The-Jaaa/esp32-autonomous-chessboard/docs/final-presentation.pdf

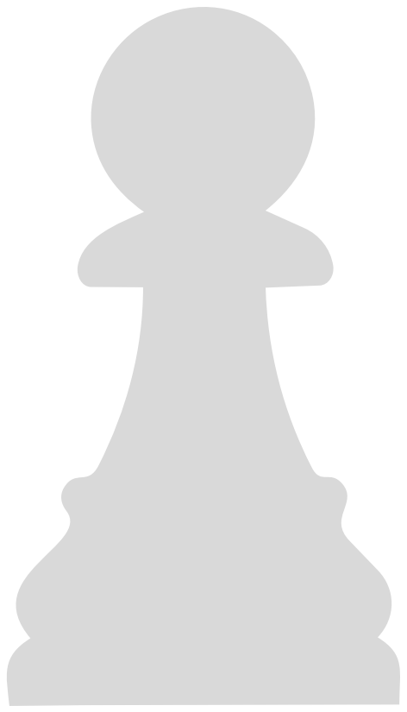
[picture p3: figure]

# CHESS COMPANION

IN 1901 - Microcontroller Based Application Development Project

IT Group 27 - Roasted Resistors

# TEAM MEMBERS

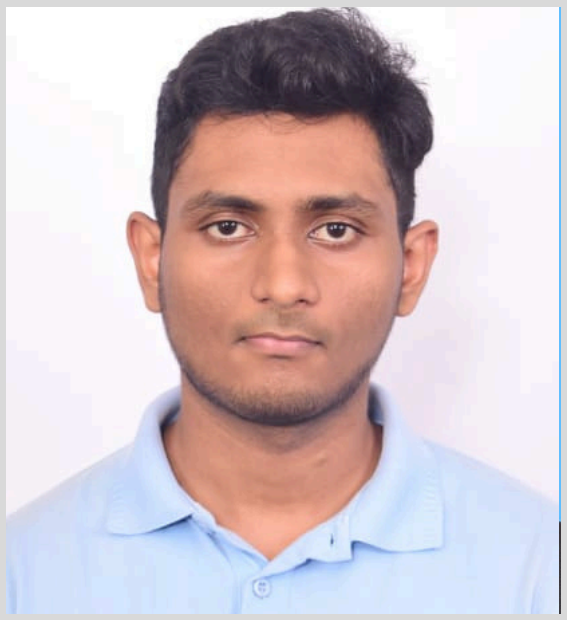
[picture p4: figure]

Thejaka Seneviratne
244195V

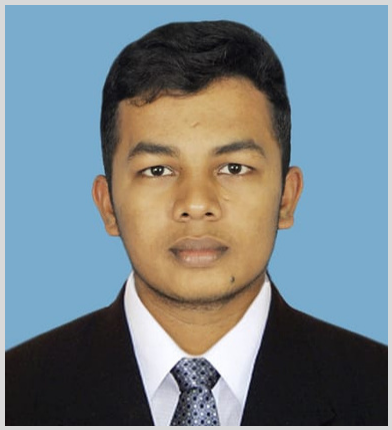
[picture p5: figure]

Sithum Sandaruwan
244189G

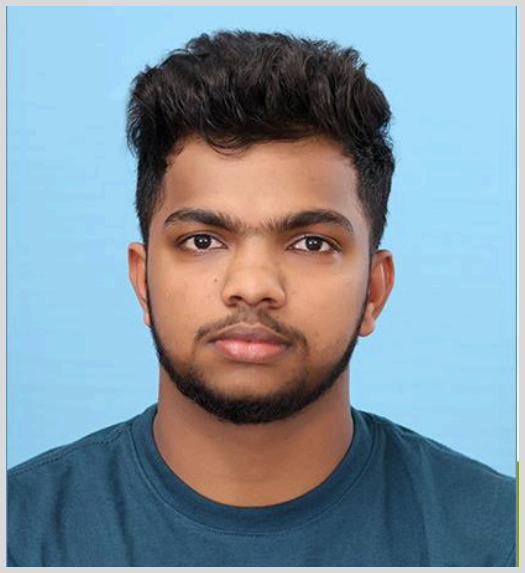
[picture p6: figure]

Avindu Thilakarathne
244206J

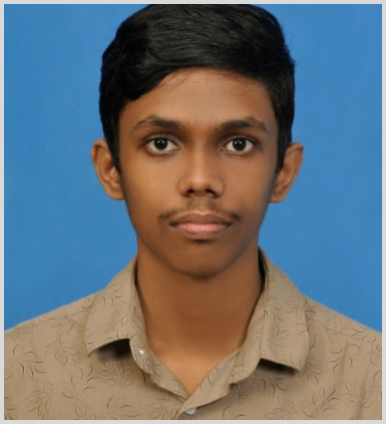
[picture p7: figure]

Sahan Wijerathne
244227A

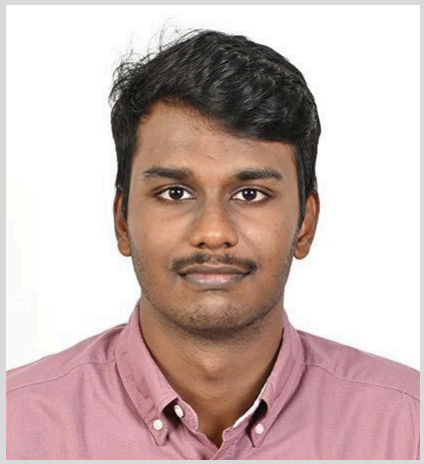
[picture p8: figure]

Harishan Nirmalan
244074B

# Table of Content

## Introduction Aim Objective Problem Solution Block Diagram

## Components

## Schematics

## Product View Work Distribution

# Introduction

Autonomous Chessboard is a smart physical chessboard that combines sensors, motors, electronics, and AI. In a game, a human plays one side while the Stockfish chess engine plays the other. Hall-effect sensors detect the positions of the pieces, while an ESP32-S3 controls a moving system and electromagnet to move the engine’s pieces automatically. The board has 256 LEDs that show legal moves, captures, special moves, warnings, and game results. Speakers provide voice feedback and coaching through a Gemini mentor, which can analyze positions, explain mistakes, change the difficulty level, and teach chess openings. A web application connects and controls all these features. Offline engine support and fully standalone play are also being

developed.

# AIM

The aim of this project is to develop an autonomous physical chessboard that allows a human player to play against an AI opponent in a realistic and interactive way. By combining a real chessboard with artificial intelligence, the project aims to make chess practice more engaging, reduce dependence on

screens, and help players improve their skills.

# OBJECTIVES

## To build a physical chessboard that can move pieces automatically using a

hidden gantry and electromagnet.
To use Hall-effect sensors to detect the position of every chess piece.

## To integrate Stockfish so the system can play against a human at different

difficulty levels.
To use LEDs to show legal moves, captures, warnings, and game results. To develop a web application for game settings and live game information.

## To add speakers and a Gemini voice mentor for chess explanations and

coaching.

## To combine all hardware and software components into one reliable chess-

playing system.

# PROBLEM

## Finding a human opponent is not always easy, making solo chess practice

difficult.

## Digital chess applications require long periods of screen use, which can cause

eye strain.

## Digital platforms do not provide the physical experience of moving real chess

pieces.

## Traditional chessboards usually do not provide an automatic opponent, move

guidance, or learning support.

## There is a need for a system that combines the physical experience of chess with

the benefits of AI.

# SOLUTION

## Provide an AI opponent using Stockfish so players can practise chess without

needing another person.

## Use a physical board with real chess pieces to create a more hands-on

experience.
Use sensors to detect player moves and automatically move the AI’s pieces. Use LEDs to show legal moves, captures, warnings, and other game information.

## Use speakers and a Gemini voice mentor to explain moves and help players

learn.

## Use a web application to manage the game, settings, difficulty level, and live

board state.

## Reduce the need for continuous screen use while keeping the benefits of a digital

chess system.

B

L

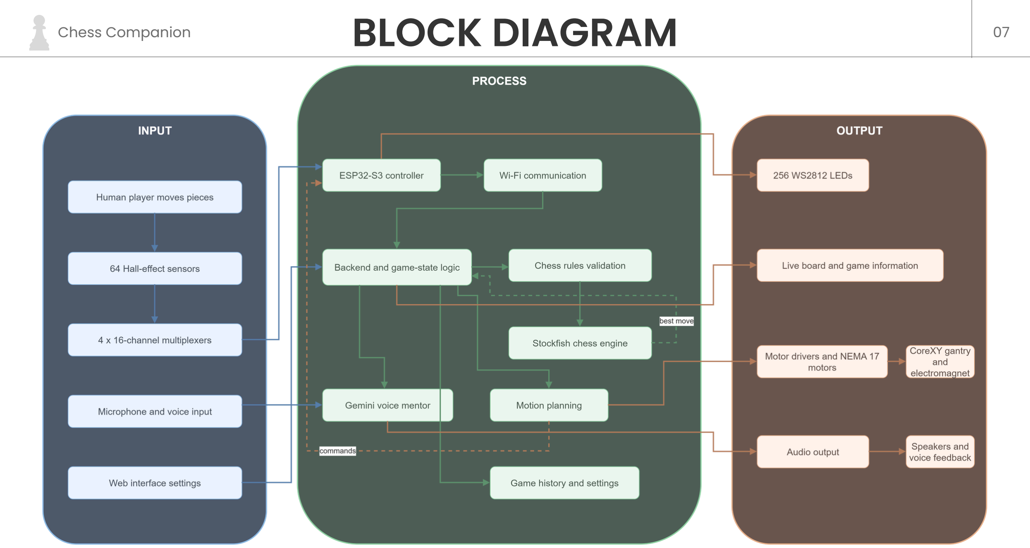
[picture p9: page 9]

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
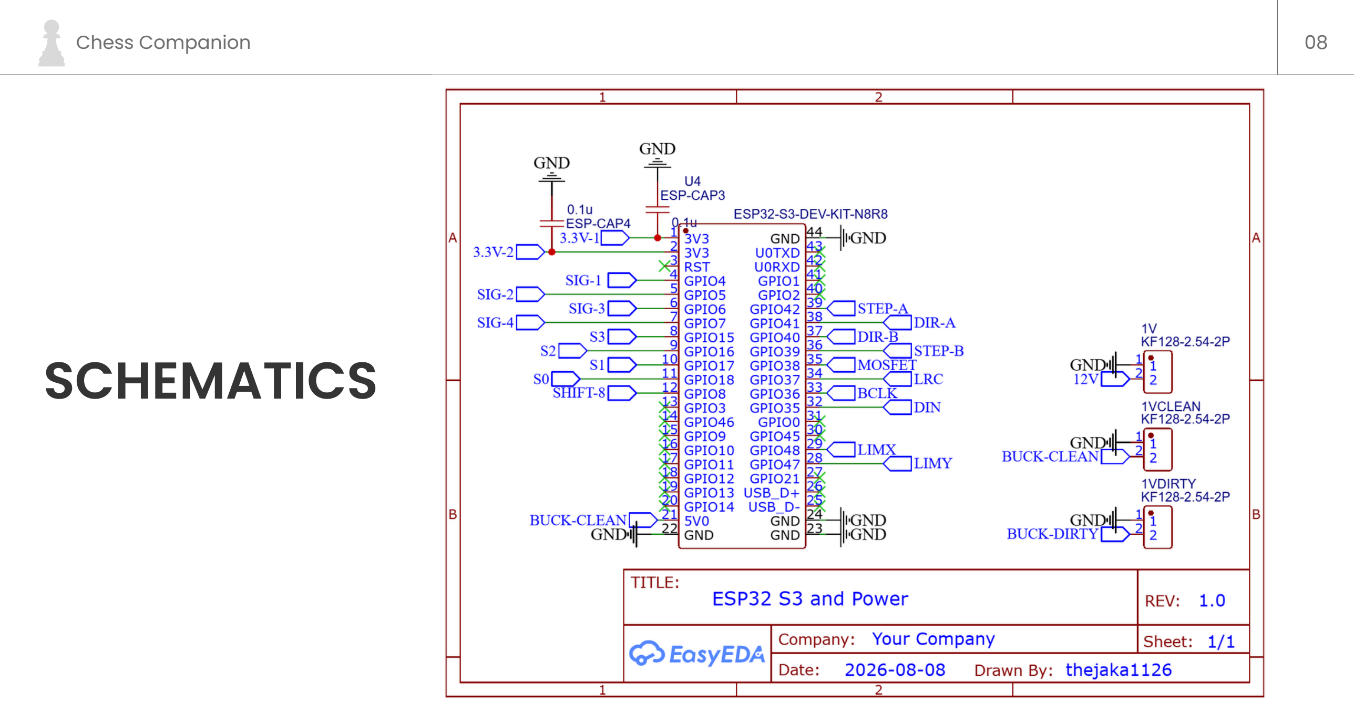
[picture p10: figure]
SCHEMATICS

S

C

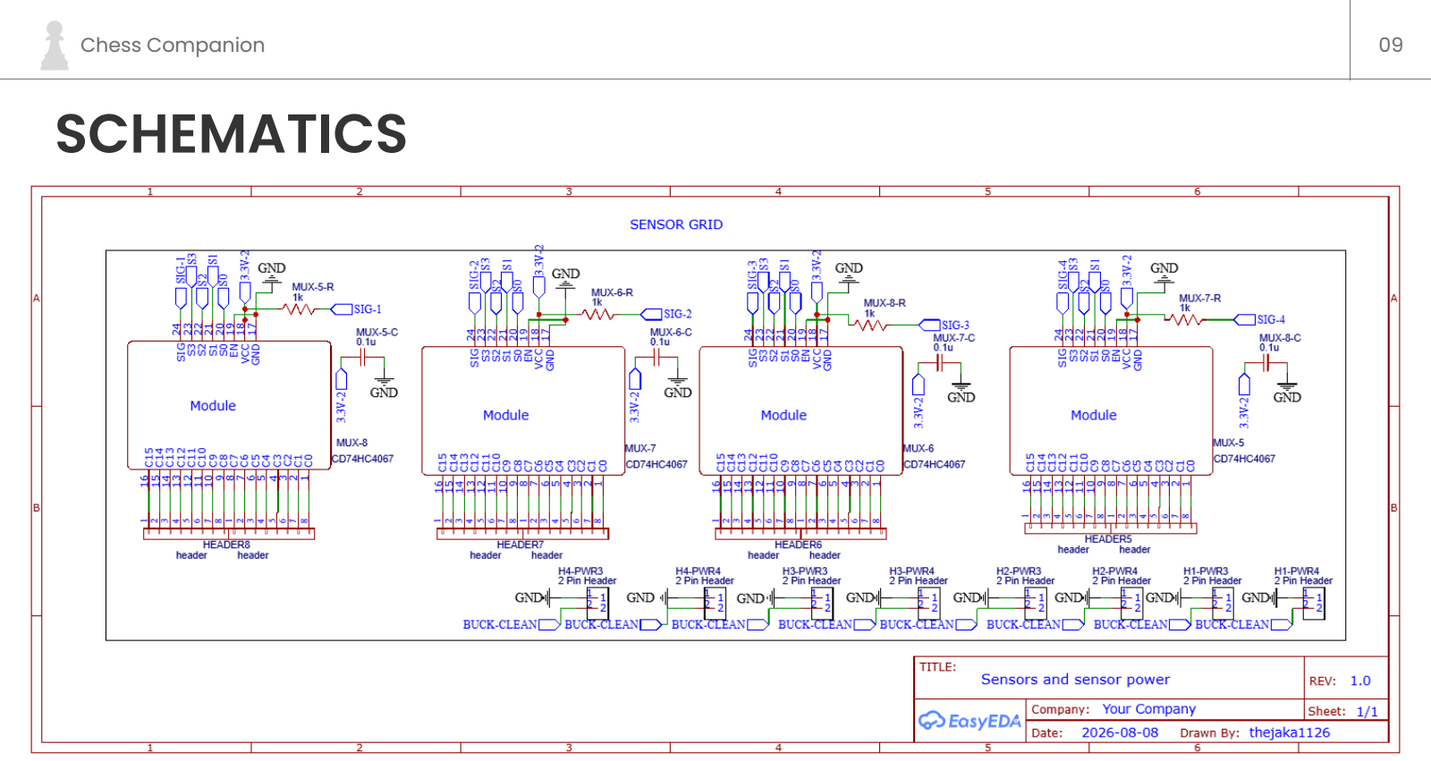
[picture p11: page 11]

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
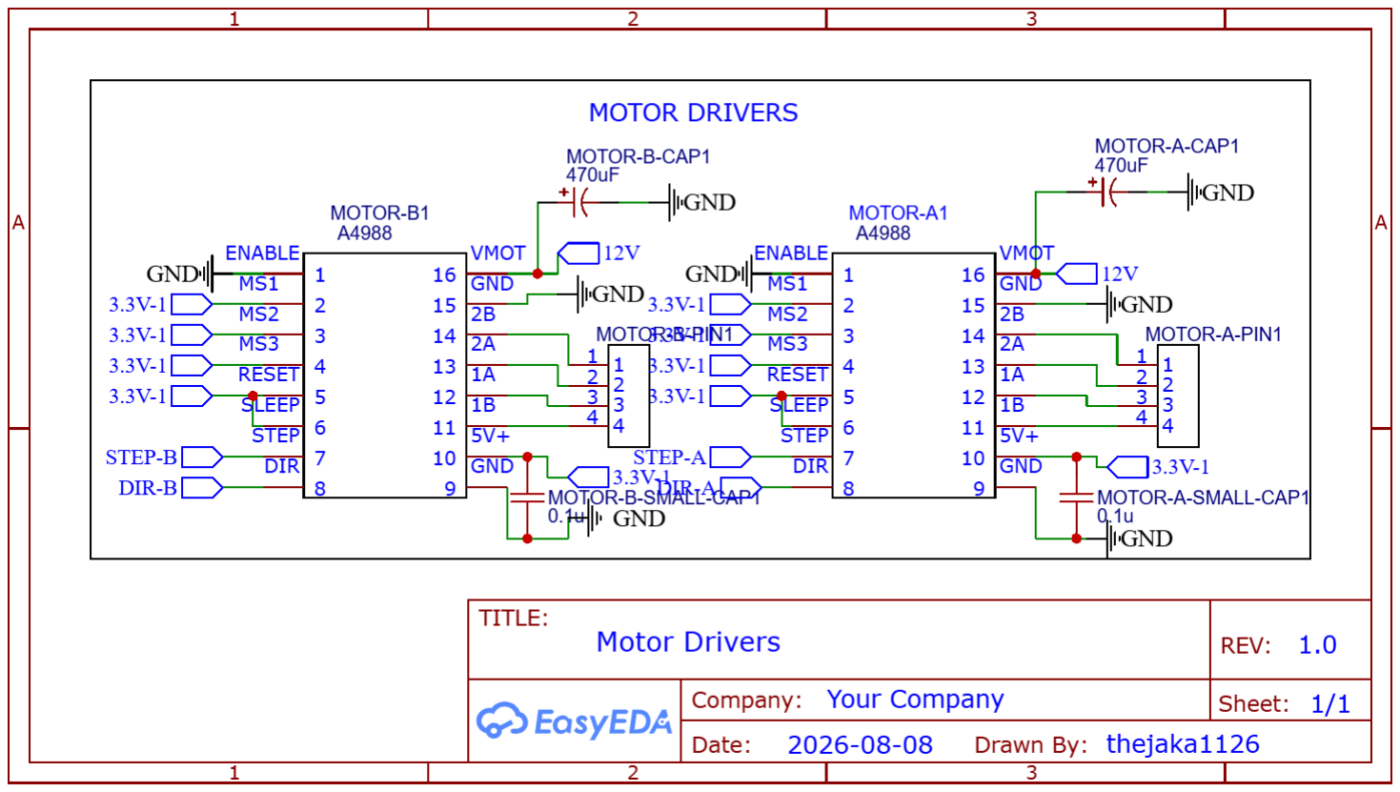
[picture p12: figure]

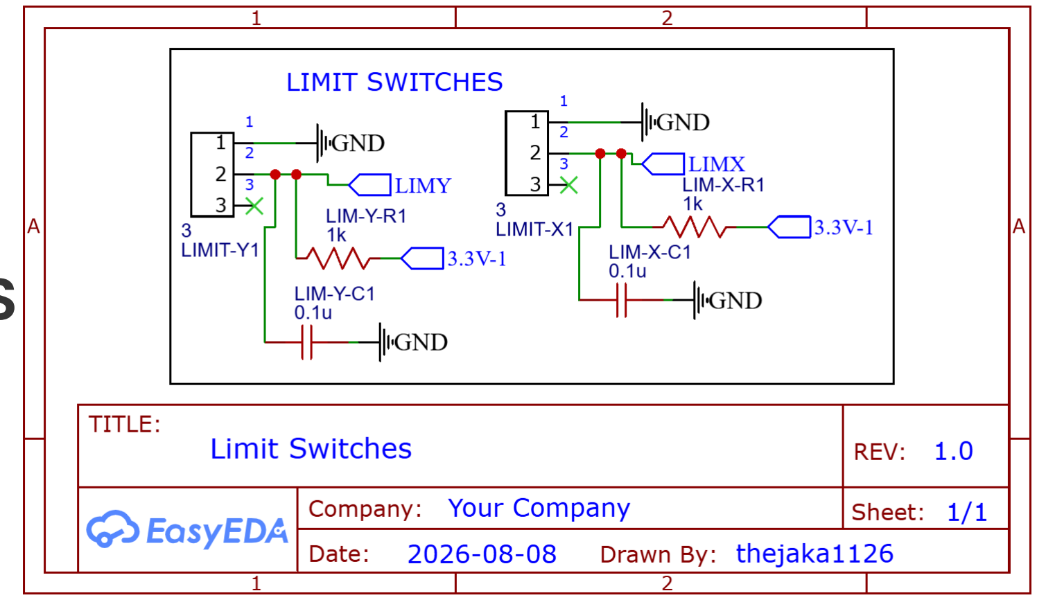
[picture p13: figure]

# SCHEMATICS

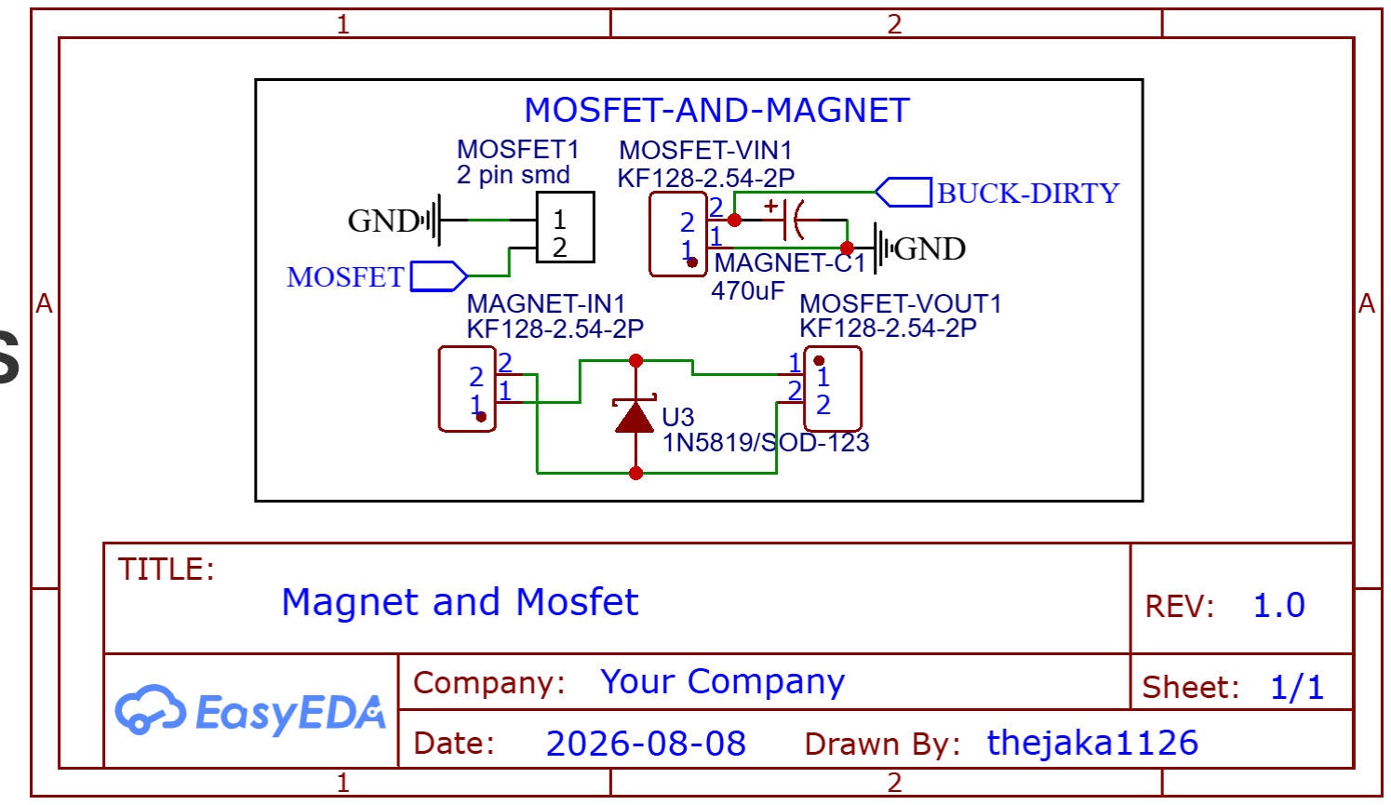
[picture p14: figure]

# SCHEMATICS

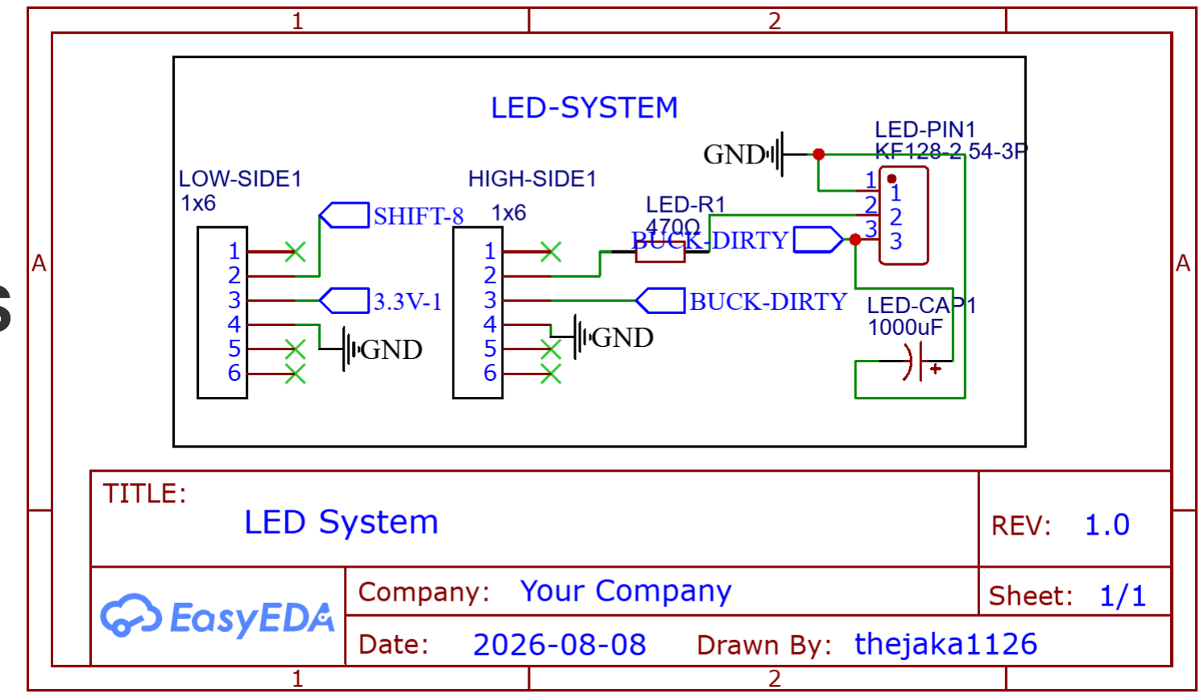
[picture p15: figure]

# SCHEMATICS

S

C

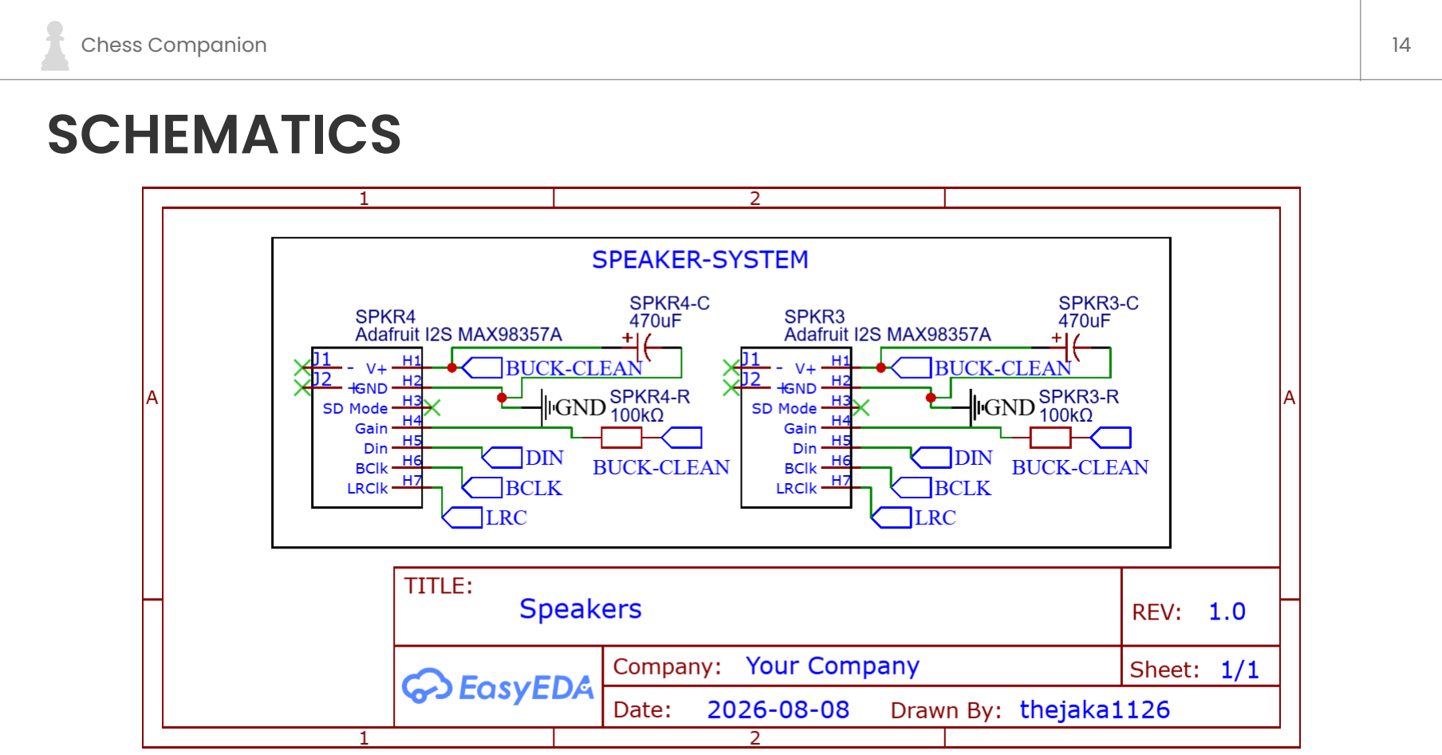
[picture p16: page 16]

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
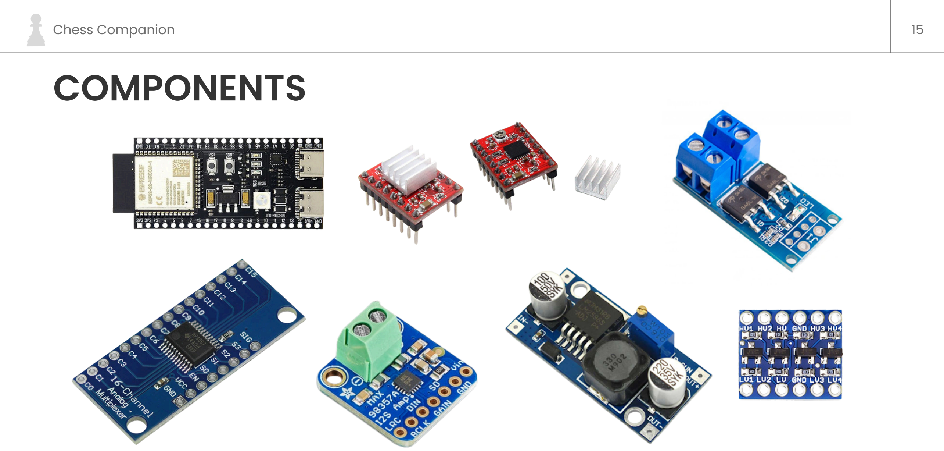
[picture p17: page 17]

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
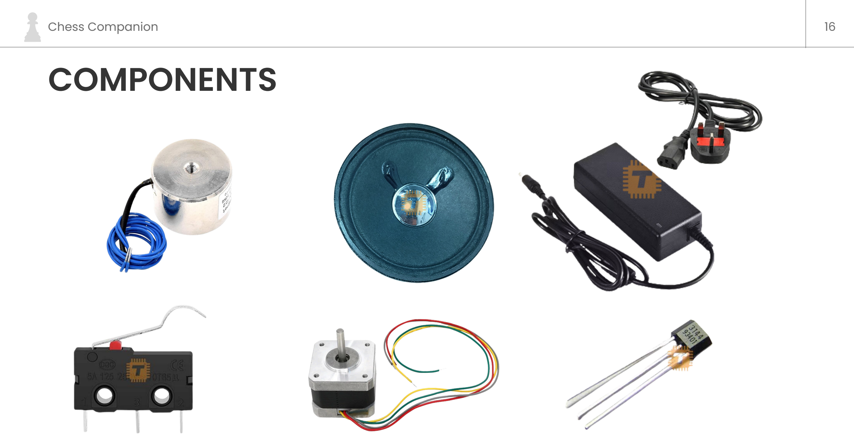
[picture p18: page 18]

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
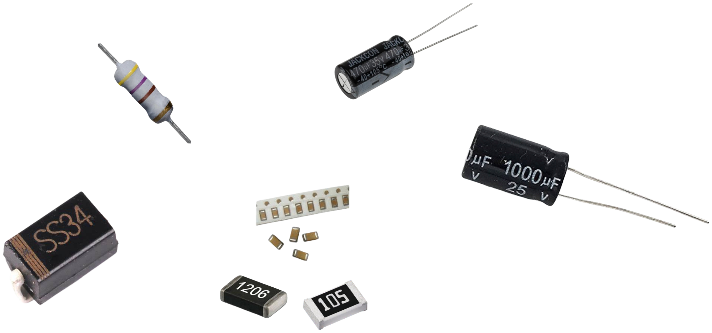
[picture p19: figure]

C

O

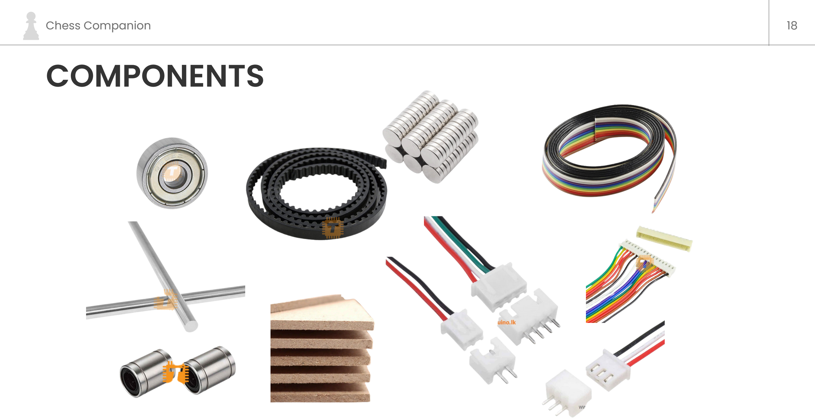
[picture p20: page 20]

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
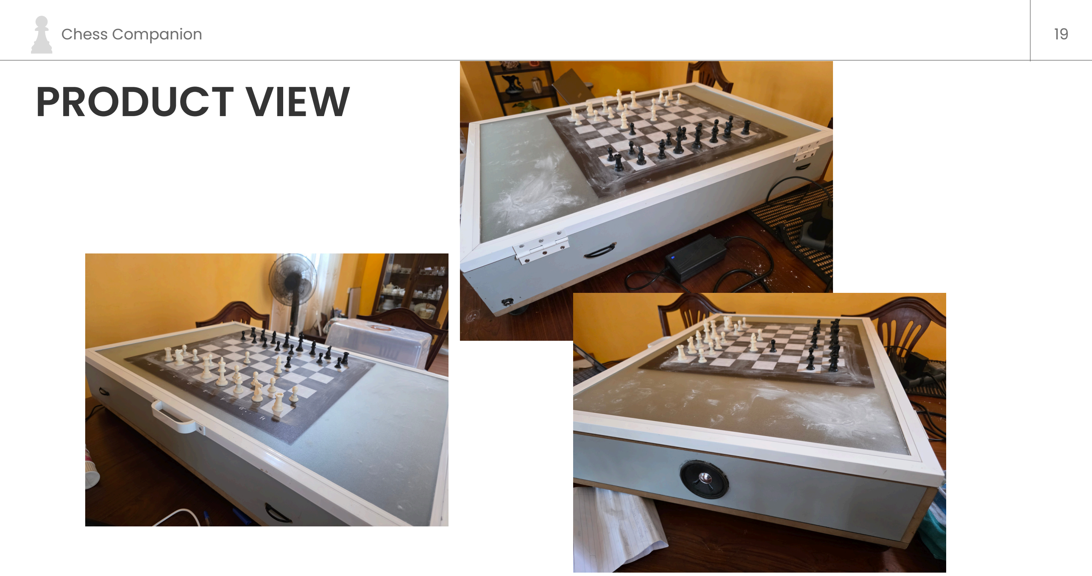
[picture p21: page 21]

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
# WORK DISTRIBUTION

# WORK BREAKDOWN STRUCTURE

1.Enclosure — Sahan 2.Stepper Motors and Motor Control — Avindu 3.Electromagnet System — Harishan 4.CoreXY Gantry — Thejaka 5.Limit Switches — Sahan 6.Speaker System — Sithum 7.LED System — Sithum 8.Sensor System — Thejaka 9.PCB and Circuit Design — Avindu 10.Power Supply — Sahan 11.Chessboard Sticker and Grid — Thejaka 12.Basic Web Application — Thejaka

## The project was divided into 12 main sections. Each section was led by a team

member and supported by other members where needed.

WBS Code | Task | Assigned member
1.1 | Confirm box dimensions and internal layout | Sahan
1.2 | Measure and mark MDF panels | Sahan
1.3 | Cut panels and drill mounting holes | Sahan
1.4 | Assemble the box and check alignment | Sahan
1.5 | Sand the box and prepare cable openings | Sahan
1.6 | Install internal mounts and check the fit | Avindu
1.7 | Assist with mounting and cable clearance | Harishan
2.1 | Identify stepper motors, drivers and wiring | Avindu
2.2 | Test basic stepper motor movement | Avindu, Thejaka
2.3 | Calculate steps for each chessboard square | Avindu
2.4 | Control motors and map board positions | Avindu, Thejaka
2.5 | Fix direction, alignment and missed-step issues | Avindu
2.6 | Prepare and secure motor-driver wiring | Thejaka, Harishan

WBS Code | Task | Assigned member
3.1 | Connect the MOSFET and electromagnet for testing | Harishan
3.2 | Test magnet switching and movement | Harishan
3.3 | Combine the electromagnet with the gantry | Harishan, Thejaka
3.4 | Test pickup and drop of magnetic pieces | Harishan
3.5 | Insulate and secure electromagnet wires | Sithum
3.6 | Prepare magnet mounting hardware and wire strain relief | Harishan
4.1 | Take dimensions and determine grid spacing | Thejaka
4.2 | Design the CoreXY layout | Thejaka
4.3 | Build the gantry frame | Thejaka
4.4 | Install rods, bearings, belts and motor mounts | Thejaka, Sahan, Harishan
4.5 | Align the frame and check smooth movement | Thejaka, Avindu
4.6 | Measure rods and tighten mechanical fasteners | Sahan

WBS Code | Task | Assigned member
5.1 | Decide the limit switch positions | Sahan
5.2 | Mount the limit switches | Sahan
5.3 | Connect and test the limit-switch wiring | Sithum
5.4 | Test homing and adjust trigger positions | Sahan
5.5 | Label and secure limit-switch wires | Thejaka
6.1 | Check speaker operation and range | Sithum
6.2 | Test stored sounds and audio | Sithum
6.3 | Mount speakers and route the wires | Sithum
6.4 | Check volume, sound quality and connectors | Sithum
7.1 | Test WS2812 LED strips with basic code | Sithum
7.2 | Design the final LED grid | Sithum
7.3 | Solder the 64 LED grids and inspect the joints | Sithum, Sahan, Harishan
7.4 | Connect LED power and data lines | Sithum, Harishan
7.5 | Test the LED grids and repair faults | Sithum
7.6 | Label LED order and verify square positions | Avindu

WBS Code | Task | Assigned member
8.1 | Test 16 Hall sensors with one multiplexer | Thejaka
8.2 | Design the sensor-line and veroboard layout | Thejaka
8.3 | Solder the sensors and connect ribbon wires | Thejaka, Sithum
8.4 | Connect the multiplexers and fix issues | Thejaka
8.5 | Test the complete 64-square sensor system | Thejaka, Avindu
8.6 | Label sensor rows, columns and wires | Sithum
9.1 | Identify circuit components and connections | Avindu
9.2 | Design the circuit schematic | Avindu
9.3 | Plan wire routing and PCB tracks | Avindu, Thejaka
9.4 | Adjust the design after testing | Avindu
9.5 | Check connectors, labels and power-ground continuity | Sithum, Harishan

WBS Code | Task | Assigned member
10.1 | Check datasheets and power requirements | Sahan
10.2 | Separate the 12 V and 5 V power rails | Sahan
10.3 | Design a compact voltage-management module | Sahan
10.4 | Assemble the power-management and distribution system | Sahan, Sithum
10.5 | Measure voltages under load and fix issues | Sahan, Sithum
10.6 | Cut, strip and label power wires | Sahan, Sithum
11.1 | Check chessboard size standards | Thejaka
11.2 | Select the square size and determine positions | Thejaka
11.3 | Design and print the chessboard grid | Thejaka, Avindu
11.4 | Apply and align the chessboard sticker | Sahan
11.5 | Check sticker alignment with the LEDs and sensors | Thejaka
12.1 | Create a simple board-status interface | Thejaka
12.2 | Connect the app to the ESP32 and display moves | Thejaka
12.3 | Add basic game-state and engine communication | Thejaka
12.4 | Perform basic app testing and documentation | Thejaka, Sithum
12.5 | Test the app with the physical chessboard | Thejaka

T

E

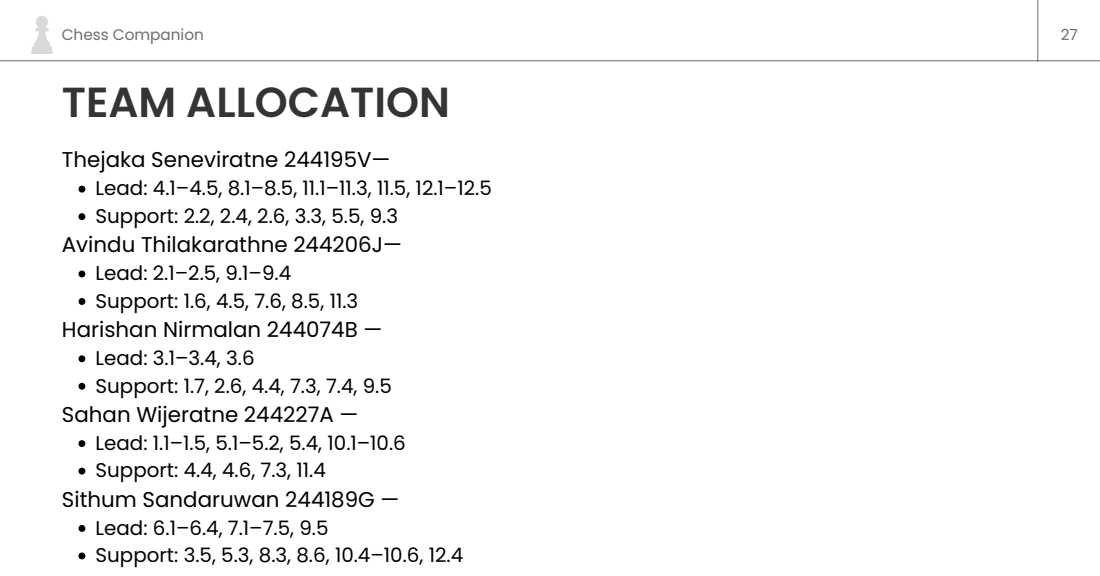
[picture p22: page 29]
nio; vir; vin; hila; ris; Nir; ala; Wij; Sit
