The-Jaaa/esp32-autonomous-chessboard/hardware/chessboard-pattern.png

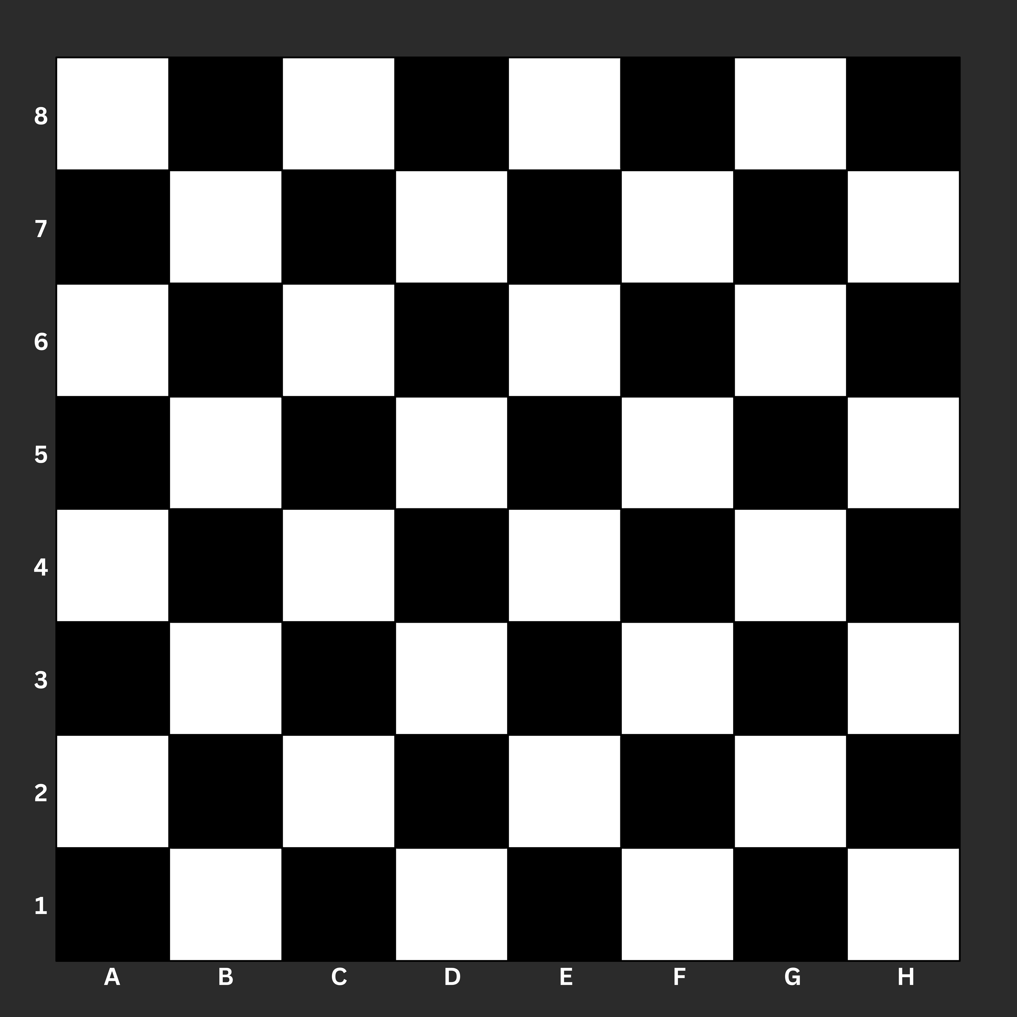
hardware/chessboard-pattern.png
