The-Jaaa/esp32-autonomous-chessboard/hardware/BOM.md

# Bill of Materials

This list captures the principal parts used in the demonstrated prototype.
Quantities do not include workshop spares.

## Control And Sensing

| Component | Quantity |
| --- | ---: |
| ESP32-S3 N16R8 development board | 1 |
| CD74HC4067 16-channel multiplexer | 4 |
| A3144 Hall-effect sensor | 64 |
| 4-channel bidirectional logic-level shifter | 1 |

## Motion And Magnet

| Component | Quantity |
| --- | ---: |
| NEMA17 stepper motor | 2 |
| A4988 stepper motor driver | 2 |
| Limit switch | 2 |
| 12 V, 15 kg electromagnet | 1 |
| 15 A dual MOSFET driver module | 1 |
| 50 cm steel rods, bearings, fasteners, and timing belt | As required |

## Lighting And Audio

| Component | Quantity |
| --- | ---: |
| WS2812-compatible addressable LED | 256 |
| MAX98357A I2S amplifier | 2 |
| 8 ohm, 3 W speaker | 2 |

## Power And Protection

| Component | Quantity |
| --- | ---: |
| 12 V, 5 A power supply | 1 |
| LM2596 buck converter | 2 |
| 1000 uF electrolytic capacitor | 1 |
| 470 uF electrolytic capacitor | 5 |
| 0.1 uF ceramic capacitor | 12 |
| 1.5 kohm SMD resistor | 6 |
| 470 ohm LED data resistor | 1 |
| SS34 Schottky flyback diode | 1 |

## Interconnects

- 10-core ribbon cable for sensor-to-PCB connections
- Four 16-pin JST connectors
- Two 4-pin JST connectors
- Three 3-pin JST connectors
- Twelve 2-pin JST connectors
- Veroboard, prototyping board, hookup wire, and strain relief
