The-Jaaa/esp32-autonomous-chessboard/docs_and_media/components.md

main components:

1. nema 17 stepper motors x2
2. limit switches x2
3. 15kg 12V electromagnet x1
4. ESP32 S3 N16R8 devkit x1
5. CD74HC4067 16 channel multiplexer x4
6. A4988 stepper motor drivers x2
7. MAX98357 speaker amplifiers x2
8. 8ohm 3W speakers x2
9. A3144 hall effect sensor x64
10. LM2596 buck converter x2
11. pixel SMD strip LED WS2812 x256 LEDs in 64 2x2 grids
12. 12V 5A powersupply
13. dual mosfet driver module PWM 15A
14. 4 channel 3.3v 5v bi-directional logic level shifter
15. Capacitors, resistors and diodes:

    1. 1000uf x1
    2. 470uf x5
    3. 0.1 ceramic smd x12
    4. 1.5kohm smd resistors x6
    5. 470ohm resistor x1 (for LEDs)
    6. ss34 Schottky diode (for electromagent)
16. Wires:

    1. 10 core ribbon cable (sensor line to PCB)
    2. 16 pin jst connectors x4
    3. 4 pin jst connectors x2
    4. 3 pin jst connectors x3
    5. 2 pin jst connectors x12 (sensor power, PCB power, electromagnet)
17. miscellaneous:

    1. 50cm steel rods, bearings, screws, GT10 timing belt, wires, vero boards, dot boards
