The-Jaaa/esp32-autonomous-chessboard/docs_and_media/main parts.txt

MDF box
stepper motors
gantry
electromagnet
limit switches
speakers
LED system
sensor system
PCB designing
power supply
sticker of chess board

ok now we're gonna move onto the report and documentation part which willl have a report, presentation and a poster template we have to complete of our project, try to remember everythign in the 2 chats, the gemini.md and codex.md.

there are some documents in the docs_and_media folder, do not copy anything from those unless i say so, only use the structure of the report and the jayalath document for the individual contribution parts of our document.

theres also a block diagram as well, it may need to have more components added, we'll go through that later in the process.

also we though of following a work breakdown structure which IDs tasks and assigns those IDs to each member type of thing to keep everything readable and also we're planning to add that to our presentation as well.
