The-Jaaa/esp32-autonomous-chessboard/docs_and_media/Untitled Diagram.drawio.pdf

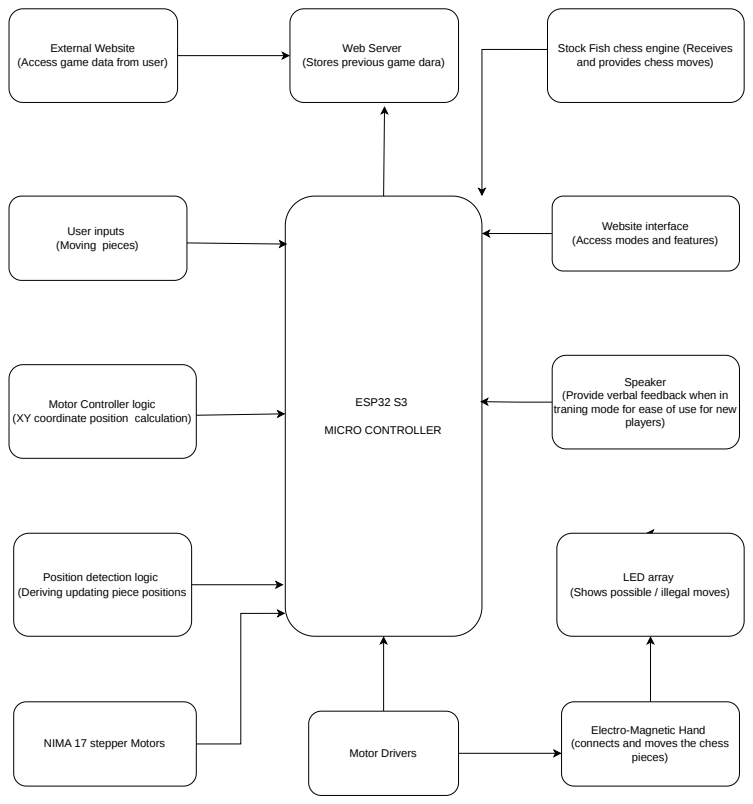
[picture p24: page 1]
ESP32 S3; MICRO CONTROLLER; Web Server; Speaker; players); LED array; Motor Drivers; pieces); User inputs (Moving pieces)

External Website
(Access game data from user)

Stock Fish chess engine (Receives
and provides chess moves)

(Stores previous game dara)

Website interface
(Access modes and features)

(Provide verbal feedback when in
traning mode for ease of use for new

Motor Controller logic
(XY coordinate position calculation)

Position detection logic
(Deriving updating piece positions

(Shows possible / illegal moves)

Electro-Magnetic Hand
(connects and moves the chess

NIMA 17 stepper Motors
