The-Jaaa/esp32-autonomous-chessboard/hardware/PCB_chessboard_2026-08-13.pdf

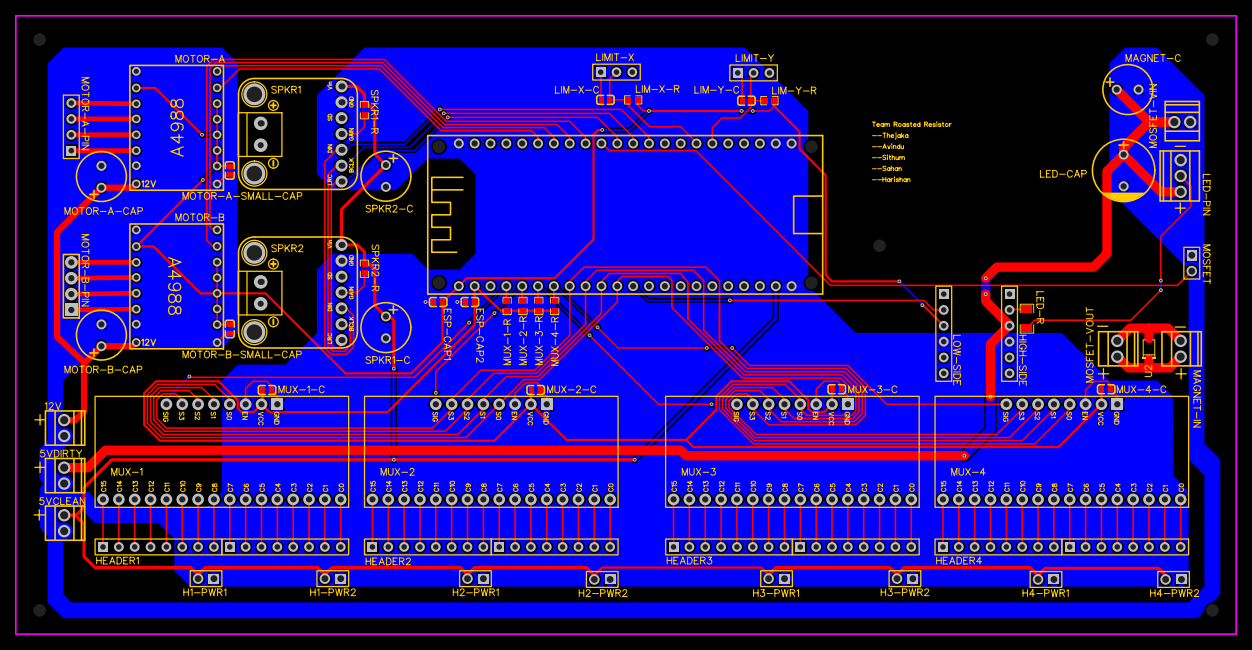
[picture p25: page 1]
