The-Jaaa/esp32-autonomous-chessboard/hardware/Schematic_chessboard_2026-06-21.pdf

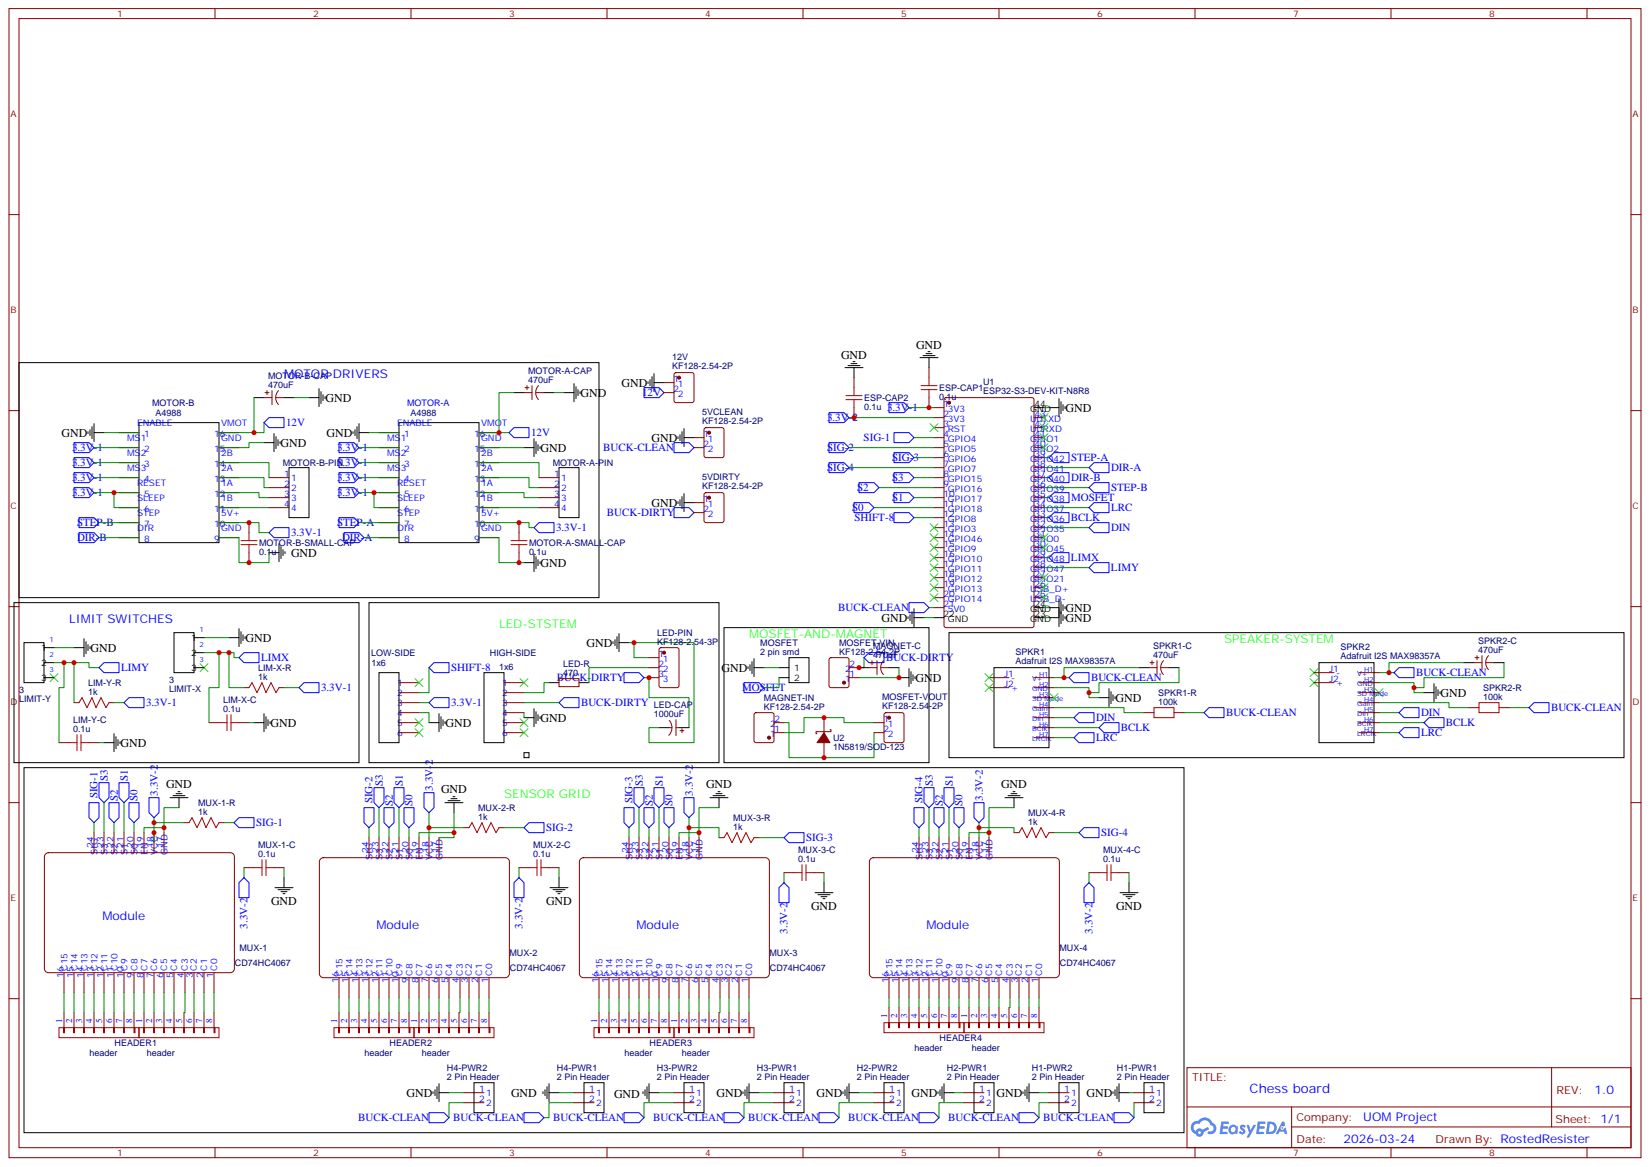
[picture p26: page 1]
