The-Jaaa/esp32-autonomous-chessboard/esp32_firmware/esp32_firmware.ino

#include <WiFi.h>

#include <HTTPClient.h>
#include <ArduinoJson.h>
#include <AccelStepper.h>
#include <Adafruit_NeoPixel.h>
#include <math.h>

#include "audio_coordinator.h"

#if __has_include("firmware_secrets.h")
#include "firmware_secrets.h"
#else
#include "firmware_secrets.example.h"
#endif

#ifndef CHESS_AUDIO_SERVER_HOST
#define CHESS_AUDIO_SERVER_HOST "YOUR_SERVER_IP"
#endif
#ifndef CHESS_AUDIO_SERVER_PORT
#define CHESS_AUDIO_SERVER_PORT 3001
#endif
#ifndef CHESS_AUDIO_BOARD_ID
#define CHESS_AUDIO_BOARD_ID "main-board"
#endif
#ifndef CHESS_AUDIO_TOKEN
#define CHESS_AUDIO_TOKEN "GENERATE_A_PRIVATE_AUDIO_TOKEN"
#endif

const char* WIFI_SSID = CHESS_WIFI_SSID;
const char* WIFI_PASSWORD = CHESS_WIFI_PASSWORD;
const char* SERVER_BASE_URL = CHESS_SERVER_BASE_URL;
const char* AUDIO_SERVER_HOST = CHESS_AUDIO_SERVER_HOST;
const char* AUDIO_BOARD_ID = CHESS_AUDIO_BOARD_ID;
const char* AUDIO_TOKEN = CHESS_AUDIO_TOKEN;

// --- CoreXY Pin Definitions ---
constexpr uint8_t MOTOR_A_STEP_PIN = 42;
constexpr uint8_t MOTOR_A_DIR_PIN  = 41;
constexpr uint8_t MOTOR_B_STEP_PIN = 39;
constexpr uint8_t MOTOR_B_DIR_PIN  = 40;
constexpr uint8_t MAGNET_PIN       = 38;
constexpr uint8_t LIMIT_Y_PIN      = 47;
constexpr uint8_t LIMIT_X_PIN      = 48;

// --- NeoPixel & MUX Pin Definitions ---
#define LED_PIN 8
#define SIG1_PIN 4
#define SIG2_PIN 5
#define SIG3_PIN 6
#define SIG4_PIN 7
#define S0 18
#define S1 17
#define S2 16
#define S3 15

#define NUM_LEDS 256
#define SWITCH_UNPRESSED LOW
#define SWITCH_PRESSED HIGH

constexpr uint8_t SENSOR_DEBOUNCE_SCANS = 4;
constexpr uint32_t SNAPSHOT_MIN_INTERVAL_MS = 120;
constexpr uint32_t POLL_INTERVAL_MS = 180;
constexpr uint32_t WIFI_RETRY_INTERVAL_MS = 10000;

constexpr float FAST_MAX_SPEED = 20000.0f;
constexpr float FAST_ACCEL = 20000.0f;
constexpr float DRAG_MAX_SPEED = 8000.0f;
constexpr float DRAG_ACCEL = 8000.0f;

constexpr int NUDGE_STEP = 300;
constexpr int NUDGE_ATTEMPTS = 8;
constexpr int DRAG_OVERSHOOT_STEPS = 250;
constexpr long HALO_NEIGHBOR_MAX_DELTA = 5200;

AccelStepper motorA(1, MOTOR_A_STEP_PIN, MOTOR_A_DIR_PIN);
AccelStepper motorB(1, MOTOR_B_STEP_PIN, MOTOR_B_DIR_PIN);
Adafruit_NeoPixel strip(NUM_LEDS, LED_PIN, NEO_GRB + NEO_KHZ800);

// Format: {Y, X}. These are raw physical sensor/LED/gantry indexes.
// Chess-square mapping is owned by app/server.js because the board orientation
// and wiring do not match standard chess order.
const long squareCoordinates[64][2] = {
  {3100, 1400}, {2900, 5400}, {2900, 9600}, {2800, 13400}, {2800, 17300}, {2850, 21200}, {2750, 25350}, {2750, 29450},
  {7000, 29350}, {7000, 25350}, {7050, 21450}, {7100, 17600}, {7200, 13600}, {7250, 9550}, {7350, 5425}, {7300, 1375},
  {11150, 1375}, {11100, 5475}, {11100, 9500}, {11100, 13400}, {11150, 17300}, {11100, 21550}, {11000, 25300}, {11000, 29400},
  {14750, 29375}, {14800, 25475}, {14875, 21425}, {14925, 17425}, {14925, 13425}, {14925, 9375}, {14950, 5225}, {15075, 1475},
  {18975, 1425}, {18975, 5275}, {18875, 9225}, {18925, 13225}, {19025, 17625}, {19025, 21475}, {18975, 25275}, {18975, 29475},
  {22850, 29300}, {22900, 25300}, {22900, 21500}, {22950, 17400}, {23050, 13450}, {23025, 9350}, {23025, 5300}, {23075, 1300},
  {27175, 1350}, {27175, 5100}, {27125, 9200}, {27125, 13500}, {27075, 17500}, {27075, 21200}, {27025, 25250}, {26975, 29300},
  {30975, 29300}, {30925, 25300}, {31025, 21325}, {30925, 17325}, {30925, 13275}, {30975, 9275}, {31075, 5475}, {31125, 1425}
};

bool stableOccupancy[64] = {false};
bool candidateOccupancy[64] = {false};
uint8_t candidateCounts[64] = {0};
bool snapshotDirty = true;
uint32_t lastSnapshotPostMs = 0;
uint32_t snapshotSeq = 0;

long currentX = 0;
long currentY = 0;

SemaphoreHandle_t sharedMutex;
String pendingMotionCommandJson;
bool hasPendingMotionCommand = false;
String pendingJobResultJson;
bool hasPendingJobResult = false;
String lastMotionFailedPhase = "";
int lastMotionFailedStep = -1;
constexpr uint8_t LED_COMMAND_QUEUE_CAPACITY = 16;
String pendingLedCommands[LED_COMMAND_QUEUE_CAPACITY];
uint8_t pendingLedCommandHead = 0;
uint8_t pendingLedCommandTail = 0;
uint8_t pendingLedCommandCount = 0;

struct PromotionLedDisplay {
  bool active = false;
  String transactionId;
  String state;
  char displayedPiece = 0;
  char lockedPiece = 0;
  int targetIndex = -1;
  uint8_t choiceIndex = 0;
  uint32_t intervalMs = 2500;
  uint32_t lastChangeMs = 0;
};

PromotionLedDisplay promotionLedDisplay;

enum LedAnimationMode {
  LED_ANIM_NONE,
  LED_ANIM_CHECKMATE,
  LED_ANIM_DRAW,
  LED_ANIM_STALEMATE
};

LedAnimationMode activeLedAnimation = LED_ANIM_NONE;
uint32_t lastLedAnimationMs = 0;
int ledAnimationKingA = -1;
int ledAnimationKingB = -1;

void scanSensors();
void handleWifiEvent(WiFiEvent_t event, WiFiEventInfo_t info);
void markSnapshotDirty();
bool postSnapshot(bool force);
bool postJson(const String& endpoint, const String& payload, String* responseOut = nullptr, int* statusOut = nullptr);
void applyImmediateLedCommands(const String& response);
void networkTask(void* parameter);
void pollPhysicalCommands();
void executeMotionCommand(const String& commandJson);
void executeDiagnosticCommand(JsonObject command);
bool executeRobotMove(JsonObject command, String& error);
bool executeMotionPlan(JsonObject command, String& error);
bool goToPlanTarget(JsonObject target, bool dragging, String& error, bool overshootBoardDrop = false);
void queueJobResult(const String& id, bool success, const String& error);
void setMotionProfile(bool dragging);
void goToXY(long targetX, long targetY, bool dragging);
void goToSquare(int index, bool dragging);
void goToSquareWithDragOvershoot(int index);
bool homeGantry();
bool movePieceBetweenSquares(int fromIndex, int toIndex);
bool movePieceToCoordinate(int fromIndex, long targetX, long targetY);
bool verifySquareState(int index, bool expectedOccupied, uint32_t timeoutMs);
bool nudgeUntilDetected(int targetIndex);
void applyLedCommand(JsonObject command);
bool enqueueLedCommand(JsonObject command);
void serviceLedCommandQueue();
void servicePromotionLedDisplay(uint32_t now);
void applyPromotionLedCommand(JsonObject command);
void setSquareColor(int squareNumber, uint8_t r, uint8_t g, uint8_t b);
void updateLedAnimation();
uint32_t colorWheel(byte position);
void clearBoardLeds();
void setNeighborSquaresColor(int centerIndex, uint8_t r, uint8_t g, uint8_t b);
void applyHumanMoveConfirm(JsonObject command);
void applyCaptureStart(JsonObject step);
void runLedRunway(JsonObject step);
bool enqueueMotionCommand(const String& commandJson);

#include "autonomous_runtime.h"
#include "exhibition.h"

void setup() {
  pinMode(MAGNET_PIN, OUTPUT);
  digitalWrite(MAGNET_PIN, LOW);

  Serial.begin(115200);
  delay(200);

  sharedMutex = xSemaphoreCreateMutex();

  pinMode(LIMIT_X_PIN, INPUT_PULLUP);
  pinMode(LIMIT_Y_PIN, INPUT_PULLUP);

  pinMode(S0, OUTPUT);
  pinMode(S1, OUTPUT);
  pinMode(S2, OUTPUT);
  pinMode(S3, OUTPUT);
  pinMode(SIG1_PIN, INPUT_PULLUP);
  pinMode(SIG2_PIN, INPUT_PULLUP);
  pinMode(SIG3_PIN, INPUT_PULLUP);
  pinMode(SIG4_PIN, INPUT_PULLUP);

  strip.begin();
  strip.setBrightness(40);
  strip.show();

  setMotionProfile(false);

  WiFi.onEvent(handleWifiEvent);
  WiFi.mode(WIFI_STA);
  WiFi.setSleep(false);
  WiFi.begin(WIFI_SSID, WIFI_PASSWORD);

  Serial.println("[BOOT] Physical board firmware started.");

  boardLedTaskReady = xTaskCreatePinnedToCore(ledTask, "boardLeds", 6144, nullptr, 1, nullptr, 0) == pdPASS;
  xTaskCreatePinnedToCore(networkTask, "networkTask", 12288, nullptr, 1, nullptr, 0);
  BoardAudioCoordinatorConfig audioConfig;
  audioConfig.mentor.host = AUDIO_SERVER_HOST;
  audioConfig.mentor.port = CHESS_AUDIO_SERVER_PORT;
  audioConfig.mentor.boardId = AUDIO_BOARD_ID;
  audioConfig.mentor.token = AUDIO_TOKEN;
  audioConfig.token = AUDIO_TOKEN;
  audioConfig.bclkPin = 10;
  audioConfig.lrclkPin = 9;
  audioConfig.dataPin = 11;
  audioConfig.relayVolume = 21;
  beginBoardAudioCoordinator(audioConfig);
}

void handleWifiEvent(WiFiEvent_t event, WiFiEventInfo_t info) {
  if (event == ARDUINO_EVENT_WIFI_STA_GOT_IP) {
    Serial.printf(
      "[WIFI] Connected ip=%s rssi=%d\n",
      WiFi.localIP().toString().c_str(),
      WiFi.RSSI()
    );
  } else if (event == ARDUINO_EVENT_WIFI_STA_DISCONNECTED) {
    Serial.printf(
      "[WIFI] Disconnected reason=%u status=%d\n",
      info.wifi_sta_disconnected.reason,
      WiFi.status()
    );
  }
}

void loop() {
  scanSensors();
  detectAutonomousLift();

  String commandJson;
  bool shouldExecute = false;
  if (xSemaphoreTake(sharedMutex, pdMS_TO_TICKS(2)) == pdTRUE) {
    if (hasPendingMotionCommand) {
      commandJson = pendingMotionCommandJson;
      pendingMotionCommandJson = "";
      hasPendingMotionCommand = false;
      shouldExecute = true;
      exhibitionMotionBusy = true;
    }
    xSemaphoreGive(sharedMutex);
  }

  if (shouldExecute) {
    executeMotionCommand(commandJson);
    if (xSemaphoreTake(sharedMutex, pdMS_TO_TICKS(10)) == pdTRUE) {
      exhibitionMotionBusy = false;
      xSemaphoreGive(sharedMutex);
    }
    markSnapshotDirty();
  }

  delay(2);
}

void networkTask(void* parameter) {
  uint32_t lastPollMs = 0;
  uint32_t lastWifiAttemptMs = 0;

  for (;;) {
    const uint32_t now = millis();

    if (WiFi.status() != WL_CONNECTED && now - lastWifiAttemptMs >= WIFI_RETRY_INTERVAL_MS) {
      lastWifiAttemptMs = now;
      Serial.println("[WIFI] Connecting...");
      WiFi.reconnect();
    }

    if (WiFi.status() == WL_CONNECTED) {
      String resultJson;
      bool shouldPostResult = false;
      if (xSemaphoreTake(sharedMutex, pdMS_TO_TICKS(5)) == pdTRUE) {
        if (hasPendingJobResult) {
          resultJson = pendingJobResultJson;
          shouldPostResult = true;
        }
        xSemaphoreGive(sharedMutex);
      }

      if (shouldPostResult) {
        int resultStatus = 0;
        const bool posted = postJson("/api/physical/job-result", resultJson, nullptr, &resultStatus);
        if ((posted || (resultStatus >= 400 && resultStatus < 500)) && xSemaphoreTake(sharedMutex, pdMS_TO_TICKS(10)) == pdTRUE) {
          if (pendingJobResultJson == resultJson) { pendingJobResultJson = ""; hasPendingJobResult = false; }
          xSemaphoreGive(sharedMutex);
        }
      }

      postSnapshot(false);

      if (now - lastPollMs >= POLL_INTERVAL_MS) {
        lastPollMs = now;
        pollPhysicalCommands();
      }
    }

    vTaskDelay(pdMS_TO_TICKS(25));
  }
}

void scanSensors() {
  mentorSpeakerRecordSensorScan(millis());
  for (int channel = 0; channel < 16; channel++) {
    digitalWrite(S0, bitRead(channel, 0));
    digitalWrite(S1, bitRead(channel, 1));
    digitalWrite(S2, bitRead(channel, 2));
    digitalWrite(S3, bitRead(channel, 3));
    delayMicroseconds(10);

    const bool readings[4] = {
      digitalRead(SIG1_PIN) == LOW,
      digitalRead(SIG2_PIN) == LOW,
      digitalRead(SIG3_PIN) == LOW,
      digitalRead(SIG4_PIN) == LOW
    };

    for (int mux = 0; mux < 4; mux++) {
      const int index = channel + mux * 16;
      const bool reading = readings[mux];

      if (candidateOccupancy[index] != reading) {
        candidateOccupancy[index] = reading;
        candidateCounts[index] = 1;
      } else if (candidateCounts[index] < SENSOR_DEBOUNCE_SCANS) {
        candidateCounts[index]++;
      }

      if (candidateCounts[index] >= SENSOR_DEBOUNCE_SCANS && stableOccupancy[index] != reading) {
        stableOccupancy[index] = reading;
        markSnapshotDirty();
      }
    }
  }
  detectAutonomousLift();
}

void markSnapshotDirty() {
  snapshotDirty = true;
}

bool postSnapshot(bool force) {
  const uint32_t now = millis();
  if (!force && ((!snapshotDirty && now - lastSnapshotPostMs < 1000) || now - lastSnapshotPostMs < SNAPSHOT_MIN_INTERVAL_MS)) {
    return false;
  }

  StaticJsonDocument<3072> doc;
  doc["seq"] = snapshotSeq++;
  doc["stable"] = true;
  doc["source"] = "esp32";
  JsonArray occupancy = doc.createNestedArray("occupancy");
  for (int i = 0; i < 64; i++) {
    occupancy.add(stableOccupancy[i]);
  }
  if (xSemaphoreTake(sharedMutex, pdMS_TO_TICKS(10)) == pdTRUE) {
    JsonObject runtime = doc.createNestedObject("boardRuntime");
    runtime["concurrentSpectrumSupported"] = boardLedTaskReady;
    runtime["controlledTakeoverSupported"] = true;
    runtime["acknowledgedHomingSupported"] = true;
    runtime["placementRecoverySupported"] = true; runtime["homingFault"] = homingFault;
    runtime["autonomousRunId"] = autonomousRunId;
    runtime["takeoverRequested"] = autonomousTakeover;
    runtime["autonomousInterference"] = autonomousInterference;
    runtime["exhibitionSupported"] = boardLedTaskReady;
    runtime["musicSpectrumSupported"] = musicSpectrumAvailable();
    const SpectrumRuntime spectrum = musicSpectrumRuntime();
    runtime["spectrumFrames"] = spectrum.frames;
    runtime["spectrumDroppedWindows"] = spectrum.droppedWindows;
    runtime["spectrumMaxAnalysisUs"] = spectrum.maxAnalysisUs;
    JsonArray spectrumLevels = runtime.createNestedArray("spectrumLevels");
    for (float level : spectrum.levels) spectrumLevels.add(level);
    runtime["motionBusy"] = exhibitionMotionBusy;
    runtime["motionPending"] = hasPendingMotionCommand;
    runtime["magnetOn"] = digitalRead(MAGNET_PIN) == HIGH;
    runtime["exhibitionEnabled"] = exhibitionApplied.enabled;
    runtime["exhibitionRevision"] = exhibitionApplied.revision;
    runtime["exhibitionServerInstanceId"] = exhibitionApplied.server;
    xSemaphoreGive(sharedMutex);
  }
  JsonObject audioStatus = doc.createNestedObject("audioStatus");
  audioStatus["mode"] = boardAudioMode();
  audioStatus["state"] = boardAudioState();
  audioStatus["retries"] = boardAudioRetries();
  audioStatus["revision"] = boardAudioRevision();
  const char* audioError = boardAudioLastError();
  if (audioError && audioError[0]) audioStatus["lastError"] = audioError;
  if (xSemaphoreTake(sharedMutex, pdMS_TO_TICKS(2)) == pdTRUE) {
    if (promotionLedDisplay.active) {
      JsonObject promotion = doc.createNestedObject("promotionDisplay");
      promotion["transactionId"] = promotionLedDisplay.transactionId;
      promotion["state"] = promotionLedDisplay.state;
      if (promotionLedDisplay.displayedPiece) {
        char piece[2] = {promotionLedDisplay.displayedPiece, '\0'};
        promotion["displayedPiece"] = piece;
      }
    }
    xSemaphoreGive(sharedMutex);
  }

  String payload;
  serializeJson(doc, payload);

  String response;
  if (postJson("/api/physical/snapshot", payload, &response)) {
    applyImmediateLedCommands(response);
    snapshotDirty = false;
    lastSnapshotPostMs = now;
    return true;
  }

  return false;
}

void applyImmediateLedCommands(const String& response) {
  if (response.length() == 0) return;

  DynamicJsonDocument doc(12288);
  DeserializationError err = deserializeJson(doc, response);
  if (err) {
    Serial.printf("[JSON] snapshot response parse failed: %s\n", err.c_str());
    return;
  }

  JsonArray commands = doc["immediateCommands"].as<JsonArray>();
  if (commands.isNull()) return;

  for (JsonObject command : commands) {
    const char* type = command["type"] | "";
    if (strcmp(type, "led") == 0) {
      enqueueLedCommand(command);
    }
  }
}

bool postJson(const String& endpoint, const String& payload, String* responseOut, int* statusOut) {
  if (statusOut) *statusOut = 0;
  if (WiFi.status() != WL_CONNECTED) return false;

  HTTPClient http;
  http.begin(String(SERVER_BASE_URL) + endpoint);
  http.addHeader("Content-Type", "application/json");
  const int code = http.POST(payload);
  if (statusOut) *statusOut = code;
  const String response = http.getString();
  http.end();

  if (responseOut) *responseOut = response;

  if (code >= 200 && code < 300) {
    return true;
  }

  Serial.printf("[HTTP] POST %s failed: %d %s\n", endpoint.c_str(), code, response.c_str());
  return false;
}

void pollPhysicalCommands() {
  static uint32_t lastAudioStatusSequence = UINT32_MAX;
  HTTPClient http;
  http.begin(String(SERVER_BASE_URL) + "/api/physical/poll");
  const int code = http.GET();
  const String response = http.getString();
  http.end();

  if (code < 200 || code >= 300) {
    Serial.printf("[HTTP] poll failed: %d\n", code);
    return;
  }

  DynamicJsonDocument doc(24576);
  DeserializationError err = deserializeJson(doc, response);
  if (err) {
    Serial.printf("[JSON] poll parse failed: %s\n", err.c_str());
    return;
  }

  lastSuccessfulPollMs = millis();
  receiveExhibition(doc["exhibition"].as<JsonObject>());

  JsonObject audio = doc["audio"].as<JsonObject>();
  if (!audio.isNull()) {
    const char* mode = audio["mode"] | "mentor";
    const char* streamUrl = audio["streamUrl"] | "";
    const uint32_t revision = audio["revision"] | 0;
    applyBoardAudioDesiredState(mode, streamUrl, revision);
  }
  const uint32_t audioStatusSequence = boardAudioStatusSequence();
  if (audioStatusSequence != lastAudioStatusSequence) {
    lastAudioStatusSequence = audioStatusSequence;
    markSnapshotDirty();
  }

  JsonArray commands = doc["commands"].as<JsonArray>();
  const bool exhibitionOwnsPoll = doc["exhibition"]["enabled"] | false;
  for (JsonObject command : commands) {
    JsonObject autoContext = command["autonomous"].as<JsonObject>();
    if (!autoContext.isNull() && strcmp(autoContext["runId"] | "", autonomousRunId) == 0
      && (autoContext["revision"] | uint32_t(0)) <= autonomousAcceptedRevision) continue;
    const char* type = command["type"] | "";

    if (strcmp(type, "led") == 0) {
      if (!exhibitionOwnsPoll) enqueueLedCommand(command);
    } else if (strcmp(type, "request-snapshot") == 0) {
      markSnapshotDirty();
      postSnapshot(true);
    } else if (strcmp(type, "diagnostic") == 0) {
      const char* action = command["action"] | "";
      if (strcmp(action, "magnet") == 0) {
        const int val = command["val"] | 0;
        digitalWrite(MAGNET_PIN, val ? HIGH : LOW);
        markSnapshotDirty();
      } else {
        String commandJson;
        serializeJson(command, commandJson);
        if (!enqueueMotionCommand(commandJson)) {
          const String id = command["id"] | "unknown";
          queueJobResult(id, false, "ESP32 motion queue is busy.");
        }
      }
    } else if (strcmp(type, "home") == 0 || strcmp(type, "move") == 0 || strcmp(type, "autonomous-reconcile") == 0) {
      String commandJson;
      serializeJson(command, commandJson);
      if (!enqueueMotionCommand(commandJson)) {
        const String id = command["id"] | "unknown";
        queueJobResult(id, false, "ESP32 motion queue is busy.");
      }
    }
  }
}

bool enqueueMotionCommand(const String& commandJson) {
  bool queued = false;
  if (xSemaphoreTake(sharedMutex, pdMS_TO_TICKS(10)) == pdTRUE) {
    if (!hasPendingMotionCommand) {
      DynamicJsonDocument context(12288);
      if (deserializeJson(context, commandJson) || !acceptAutonomousCommand(context.as<JsonObject>())) {
        xSemaphoreGive(sharedMutex);
        return false;
      }
      pendingMotionCommandJson = commandJson;
      hasPendingMotionCommand = true;
      queued = true;
    }
    xSemaphoreGive(sharedMutex);
  }
  return queued;
}

void executeMotionCommand(const String& commandJson) {
  DynamicJsonDocument doc(24576);
  DeserializationError err = deserializeJson(doc, commandJson);
  if (err) {
    Serial.printf("[JSON] motion command parse failed: %s\n", err.c_str());
    return;
  }

  JsonObject command = doc.as<JsonObject>();
  const char* type = command["type"] | "";
  const String id = command["id"] | "unknown";

  const bool autonomousCommand = !command["autonomous"].isNull();
  if (!autonomousCommand && !waitForMotionLeds()) {
    queueJobResult(id, false, "LED feedback did not finish before motion.");
    return;
  }
  if (homingFault && strcmp(type, "home") != 0) {
    queueJobResult(id, false, "Homing previously failed; re-home before movement.");
    return;
  }
  if (autonomousCommand) {
    for (const String& completed : autonomousCompletedIds) {
      if (completed == id) { queueJobResult(id, true, "Already completed."); return; }
    }
    if (millis() - lastSuccessfulPollMs > 5000) {
      queueJobResult(id, false, "Backend connection is stale; movement held.");
      return;
    }
  }
  if (strcmp(type, "autonomous-reconcile") == 0) {
    JsonArray expected = command["autonomous"]["expectedOccupancy"].as<JsonArray>();
    bool corrected[64] = {};
    for(int i=0;i<64 && expected.size()==64;i++) corrected[i]=expected[i].as<bool>();
    bool ok = expected.size() == 64;
    if(xSemaphoreTake(sharedMutex,pdMS_TO_TICKS(10)) == pdTRUE) {
      ok = ok && autonomousGuard.reconcile(stableOccupancy, corrected, digitalRead(MAGNET_PIN)==LOW, !homingFault);
      if(ok) {
        autonomousCompletedIds[autonomousCompletedCursor++ % 16]=id;
      }
      xSemaphoreGive(sharedMutex);
    } else ok=false;
    queueJobResult(id,ok,ok ? "" : "Correction baseline did not verify.");
    markSnapshotDirty(); return;
  }
  if (strcmp(type, "home") == 0) {
    const bool ok = homeGantry();
    homingFault = !ok;
    if (autonomousCommand) {
      if (ok) autonomousCompletedIds[autonomousCompletedCursor++ % 16] = id;
      queueJobResult(id, ok, ok ? "" : "Homing timed out; movement stopped.");
    }
    markSnapshotDirty();
    return;
  }

  if (strcmp(type, "diagnostic") == 0) {
    executeDiagnosticCommand(command);
    markSnapshotDirty();
    return;
  }

  if (strcmp(type, "move") == 0) {
    String error;
    lastMotionFailedPhase = "";
    lastMotionFailedStep = -1;
    const bool ok = executeRobotMove(command, error);
    if (ok && autonomousCommand) autonomousCompletedIds[autonomousCompletedCursor++ % 16] = id;
    queueJobResult(id, ok, error);
    markSnapshotDirty();
  }
}

void executeDiagnosticCommand(JsonObject command) {
  const char* action = command["action"] | "";

  if (strcmp(action, "magnet") == 0) {
    const int val = command["val"] | 0;
    digitalWrite(MAGNET_PIN, val ? HIGH : LOW);
    return;
  }

  if (strcmp(action, "xy") == 0) {
    const long x = command["x"] | currentX;
    const long y = command["y"] | currentY;
    const bool dragging = command["dragging"] | false;
    goToXY(x, y, dragging);
    return;
  }

  if (strcmp(action, "square") == 0) {
    const int index = command["index"] | -1;
    const bool dragging = command["dragging"] | false;
    goToSquare(index, dragging);
  }
}

bool goToPlanTarget(JsonObject target, bool dragging, String& error, bool overshootBoardDrop) {
  if (target.isNull()) {
    error = "Motion plan step is missing a target.";
    return false;
  }

  if (target["index"].is<int>()) {
    const int index = target["index"] | -1;
    if (index < 0 || index >= 64) {
      error = "Motion plan target has an invalid square index.";
      return false;
    }
    if (dragging && overshootBoardDrop) {
      goToSquareWithDragOvershoot(index);
    } else {
      goToSquare(index, dragging);
    }
    return true;
  }

  if (target["x"].is<long>() && target["y"].is<long>()) {
    const long x = target["x"] | currentX;
    const long y = target["y"] | currentY;
    goToXY(x, y, dragging);
    return true;
  }

  error = "Motion plan target needs either index or x/y coordinates.";
  return false;
}

bool executeMotionPlan(JsonObject command, String& error) {
  JsonArray plan = command["plan"].as<JsonArray>();
  if (plan.isNull() || plan.size() == 0) {
    error = "Motion plan is empty.";
    return false;
  }

  int stepIndex = 0;
  for (JsonObject step : plan) {
    if (!command["autonomous"].isNull() && autonomousInterference) {
      digitalWrite(MAGNET_PIN, LOW);
      error = "Unexpected piece placement; autonomous motion held.";
      return false;
    }
    const char* action = step["action"] | "";
    const char* phase = step["phase"] | action;
    lastMotionFailedPhase = String(phase);
    lastMotionFailedStep = stepIndex;

    if (strcmp(action, "travel") == 0) {
      digitalWrite(MAGNET_PIN, LOW);
      JsonObject target = step["to"].as<JsonObject>();
      if (!goToPlanTarget(target, false, error)) return false;
      stepIndex++;
      continue;
    }

    if (strcmp(action, "pickup") == 0) {
      digitalWrite(MAGNET_PIN, HIGH);
      delay(160);
      stepIndex++;
      continue;
    }

    if (strcmp(action, "drag") == 0) {
      digitalWrite(MAGNET_PIN, HIGH);
      JsonObject target = step["to"].as<JsonObject>();
      JsonObject nextStep = plan[stepIndex + 1].as<JsonObject>();
      const char* nextAction = nextStep["action"] | "";
      const bool finalBoardDrop = strcmp(nextAction, "drop") == 0 && target["index"].is<int>();
      if (!goToPlanTarget(target, true, error, finalBoardDrop)) return false;
      stepIndex++;
      continue;
    }

    if (strcmp(action, "drop") == 0) {
      digitalWrite(MAGNET_PIN, LOW);
      delay(80);
      const int nudgeTargetIndex = step["nudgeTargetIndex"] | -1;
      if (nudgeTargetIndex >= 0 && nudgeTargetIndex < 64 && !nudgeUntilDetected(nudgeTargetIndex)) {
        error = "Drop verification failed after nudge attempts.";
        return false;
      }
      stepIndex++;
      continue;
    }

    if (strcmp(action, "verify") == 0) {
      const int sourceEmpty = step["sourceEmpty"] | -1;
      const int targetOccupied = step["targetOccupied"] | -1;

      if (sourceEmpty >= 0 && sourceEmpty < 64 && !verifySquareState(sourceEmpty, false, 700)) {
        error = "Motion plan source square did not become empty.";
        return false;
      }

      if (targetOccupied >= 0 && targetOccupied < 64 && !verifySquareState(targetOccupied, true, 700)) {
        if (!nudgeUntilDetected(targetOccupied)) {
          error = "Motion plan target square did not become occupied.";
          return false;
        }
      }
      stepIndex++;
      continue;
    }

    if (strcmp(action, "led-capture-start") == 0) {
      queueMotionLed(step, "capture-start");
      stepIndex++;
      continue;
    }

    if (strcmp(action, "led-runway") == 0) {
      queueMotionLed(step, "led-runway");
      stepIndex++;
      continue;
    }

    error = "Motion plan contains an unknown step action.";
    return false;
  }

  lastMotionFailedPhase = "";
  lastMotionFailedStep = -1;
  return true;
}

bool executeRobotMove(JsonObject command, String& error) {
  if (command["plan"].is<JsonArray>()) {
    return executeMotionPlan(command, error);
  }

  const int fromIndex = command["fromIndex"] | -1;
  const int toIndex = command["toIndex"] | -1;
  const bool capture = command["capture"] | false;

  if (fromIndex < 0 || fromIndex >= 64 || toIndex < 0 || toIndex >= 64) {
    error = "Invalid source or target index.";
    return false;
  }

  if (command["castleRookMove"].is<JsonObject>()) {
    if (!movePieceBetweenSquares(fromIndex, toIndex)) {
      error = "Failed to move castling king.";
      return false;
    }

    JsonObject rook = command["castleRookMove"];
    const int rookFrom = rook["fromIndex"] | -1;
    const int rookTo = rook["toIndex"] | -1;
    if (!movePieceBetweenSquares(rookFrom, rookTo)) {
      error = "Failed to move castling rook.";
      return false;
    }
    return true;
  }

  if (capture) {
    const int stagingIndex = command["stagingIndex"] | -1;
    const int capturedIndex = command["capturedIndex"] | -1;
    JsonObject graveyardSlot = command["graveyardSlot"];

    if (stagingIndex < 0 || stagingIndex >= 64 || capturedIndex < 0 || capturedIndex >= 64 || graveyardSlot.isNull()) {
      error = "Capture command missing staging, captured index, or graveyard slot.";
      return false;
    }

    if (!movePieceBetweenSquares(fromIndex, stagingIndex)) {
      error = "Failed to stage attacking piece.";
      return false;
    }

    const long graveyardX = graveyardSlot["x"] | 0;
    const long graveyardY = graveyardSlot["y"] | 0;
    if (!movePieceToCoordinate(capturedIndex, graveyardX, graveyardY)) {
      error = "Failed to remove captured piece.";
      return false;
    }

    if (!movePieceBetweenSquares(stagingIndex, toIndex)) {
      error = "Failed to place attacking piece on capture square.";
      return false;
    }
    return true;
  }

  if (!movePieceBetweenSquares(fromIndex, toIndex)) {
    error = "Failed to execute normal move.";
    return false;
  }

  return true;
}

void queueJobResult(const String& id, bool success, const String& error) {
  StaticJsonDocument<1536> doc;
  doc["id"] = id;
  doc["success"] = success;
  doc["magnetOn"] = digitalRead(MAGNET_PIN) == HIGH;
  doc["takeoverRequested"] = autonomousTakeover;
  doc["autonomousInterference"] = autonomousInterference;
  if (!success) doc["error"] = error;
  if (!success && lastMotionFailedPhase.length() > 0) doc["failedPhase"] = lastMotionFailedPhase;
  if (!success && lastMotionFailedStep >= 0) doc["failedStep"] = lastMotionFailedStep;
  JsonArray occupancy = doc.createNestedArray("occupancy");
  for (int i = 0; i < 64; i++) {
    occupancy.add(stableOccupancy[i]);
  }

  String payload;
  serializeJson(doc, payload);

  if (xSemaphoreTake(sharedMutex, pdMS_TO_TICKS(20)) == pdTRUE) {
    pendingJobResultJson = payload;
    hasPendingJobResult = true;
    xSemaphoreGive(sharedMutex);
  }
}

void setMotionProfile(bool dragging) {
  motorA.setMaxSpeed(dragging ? DRAG_MAX_SPEED : FAST_MAX_SPEED);
  motorA.setAcceleration(dragging ? DRAG_ACCEL : FAST_ACCEL);
  motorB.setMaxSpeed(dragging ? DRAG_MAX_SPEED : FAST_MAX_SPEED);
  motorB.setAcceleration(dragging ? DRAG_ACCEL : FAST_ACCEL);
}

void goToXY(long targetX, long targetY, bool dragging) {
  setMotionProfile(dragging);

  const long targetA = -targetX + targetY;
  const long targetB = targetX + targetY;

  motorA.moveTo(targetA);
  motorB.moveTo(targetB);

  uint32_t lastScanMs = 0;
  while (motorA.distanceToGo() != 0 || motorB.distanceToGo() != 0) {
    if (autonomousInterference && autonomousRunId[0]) {
      motorA.moveTo(motorA.currentPosition());
      motorB.moveTo(motorB.currentPosition());
      digitalWrite(MAGNET_PIN, LOW);
      homingFault = true;
      return;
    }
    motorA.run();
    motorB.run();

    if (millis() - lastScanMs >= 4) {
      lastScanMs = millis();
      scanSensors();
      yield();
    }
  }

  currentX = targetX;
  currentY = targetY;
}

void goToSquare(int index, bool dragging) {
  if (index < 0 || index >= 64) return;
  goToXY(squareCoordinates[index][1], squareCoordinates[index][0], dragging);
}

void goToSquareWithDragOvershoot(int index) {
  if (index < 0 || index >= 64) return;

  const long targetX = squareCoordinates[index][1];
  const long targetY = squareCoordinates[index][0];
  const float dx = float(targetX - currentX);
  const float dy = float(targetY - currentY);
  const float distance = sqrtf(dx * dx + dy * dy);

  if (distance < 1.0f) {
    goToXY(targetX, targetY, true);
    return;
  }

  const long overshootX = targetX + lroundf((dx / distance) * DRAG_OVERSHOOT_STEPS);
  const long overshootY = targetY + lroundf((dy / distance) * DRAG_OVERSHOOT_STEPS);
  goToXY(overshootX, overshootY, true);
}

bool homeGantry() {
  Serial.println("[MOTION] Homing gantry.");
  setMotionProfile(false);
  digitalWrite(MAGNET_PIN, LOW);

  if (digitalRead(LIMIT_X_PIN) == SWITCH_PRESSED || digitalRead(LIMIT_Y_PIN) == SWITCH_PRESSED) {
    motorA.setCurrentPosition(0);
    motorB.setCurrentPosition(0);
    goToXY(200, 200, false);
  }

  motorA.move(1000000);
  motorB.move(-1000000);
  uint32_t axisStart = millis();
  while (digitalRead(LIMIT_X_PIN) == SWITCH_UNPRESSED) {
    if (millis() - axisStart > 15000) { motorA.setCurrentPosition(0); motorB.setCurrentPosition(0); digitalWrite(MAGNET_PIN, LOW); return false; }
    motorA.run();
    motorB.run();
    scanSensors();
    yield();
  }
  motorA.setCurrentPosition(0);
  motorB.setCurrentPosition(0);
  motorA.moveTo(0);
  motorB.moveTo(0);
  goToXY(100, 0, false);

  motorA.move(-1000000);
  motorB.move(-1000000);
  axisStart = millis();
  while (digitalRead(LIMIT_Y_PIN) == SWITCH_UNPRESSED) {
    if (millis() - axisStart > 15000) { motorA.setCurrentPosition(0); motorB.setCurrentPosition(0); digitalWrite(MAGNET_PIN, LOW); return false; }
    motorA.run();
    motorB.run();
    scanSensors();
    yield();
  }
  motorA.setCurrentPosition(0);
  motorB.setCurrentPosition(0);
  motorA.moveTo(0);
  motorB.moveTo(0);

  goToXY(0, 100, false);
  motorA.setCurrentPosition(0);
  motorB.setCurrentPosition(0);
  currentX = 0;
  currentY = 0;
  return true;
}

bool movePieceBetweenSquares(int fromIndex, int toIndex) {
  if (fromIndex < 0 || fromIndex >= 64 || toIndex < 0 || toIndex >= 64) return false;

  goToSquare(fromIndex, false);
  digitalWrite(MAGNET_PIN, HIGH);
  delay(160);
  goToSquareWithDragOvershoot(toIndex);
  digitalWrite(MAGNET_PIN, LOW);
  delay(80);

  if (!nudgeUntilDetected(toIndex)) return false;
  return verifySquareState(fromIndex, false, 600) && verifySquareState(toIndex, true, 600);
}

bool movePieceToCoordinate(int fromIndex, long targetX, long targetY) {
  if (fromIndex < 0 || fromIndex >= 64) return false;

  goToSquare(fromIndex, false);
  digitalWrite(MAGNET_PIN, HIGH);
  delay(160);
  goToXY(targetX, targetY, true);
  digitalWrite(MAGNET_PIN, LOW);
  delay(80);

  return verifySquareState(fromIndex, false, 600);
}

bool verifySquareState(int index, bool expectedOccupied, uint32_t timeoutMs) {
  const uint32_t start = millis();
  while (millis() - start < timeoutMs) {
    scanSensors();
    if (stableOccupancy[index] == expectedOccupied) return true;
    delay(20);
  }
  return stableOccupancy[index] == expectedOccupied;
}

bool nudgeUntilDetected(int targetIndex) {
  if (verifySquareState(targetIndex, true, 150)) return true;

  const long centerX = squareCoordinates[targetIndex][1];
  const long centerY = squareCoordinates[targetIndex][0];
  const int offsets[NUDGE_ATTEMPTS][2] = {
    {NUDGE_STEP, 0},
    {NUDGE_STEP * 2, 0},
    {0, NUDGE_STEP},
    {0, NUDGE_STEP * 2},
    {-NUDGE_STEP, 0},
    {-NUDGE_STEP * 2, 0},
    {0, -NUDGE_STEP},
    {0, -NUDGE_STEP * 2}
  };

  for (int i = 0; i < NUDGE_ATTEMPTS; i++) {
    goToXY(centerX + offsets[i][0], centerY + offsets[i][1], false);
    if (verifySquareState(targetIndex, true, 180)) return true;
  }

  goToXY(centerX, centerY, false);
  return verifySquareState(targetIndex, true, 180);
}

bool enqueueLedCommand(JsonObject command) {
  String commandJson;
  serializeJson(command, commandJson);
  if (xSemaphoreTake(sharedMutex, pdMS_TO_TICKS(5)) != pdTRUE) return false;
  if (pendingLedCommandCount >= LED_COMMAND_QUEUE_CAPACITY) {
    xSemaphoreGive(sharedMutex);
    Serial.println("[LED] command queue full; command dropped.");
    return false;
  }
  pendingLedCommands[pendingLedCommandTail] = commandJson;
  pendingLedCommandTail = (pendingLedCommandTail + 1) % LED_COMMAND_QUEUE_CAPACITY;
  pendingLedCommandCount++;
  xSemaphoreGive(sharedMutex);
  return true;
}

void serviceLedCommandQueue() {
  String commandJson;
  if (xSemaphoreTake(sharedMutex, pdMS_TO_TICKS(2)) == pdTRUE) {
    if (pendingLedCommandCount > 0) {
      commandJson = pendingLedCommands[pendingLedCommandHead];
      pendingLedCommands[pendingLedCommandHead] = "";
      pendingLedCommandHead = (pendingLedCommandHead + 1) % LED_COMMAND_QUEUE_CAPACITY;
      pendingLedCommandCount--;
      ledCommandBusy = true;
    }
    xSemaphoreGive(sharedMutex);
  }
  if (commandJson.length() == 0) return;
  DynamicJsonDocument doc(12288);
  if (deserializeJson(doc, commandJson)) {
    Serial.println("[LED] queued command parse failed.");
  } else {
    applyLedCommand(doc.as<JsonObject>());
  }
  if (xSemaphoreTake(sharedMutex, pdMS_TO_TICKS(10)) == pdTRUE) {
    ledCommandBusy = false;
    xSemaphoreGive(sharedMutex);
  }
}

int promotionMatrixPixelToStrip(int row, int column) {
  if (row < 0 || row >= 16 || column < 0 || column >= 16) return -1;
  const int fileIndex = row / 2;  // A through H.
  const int rank = column / 2 + 1;
  const int rawGroup = 7 - fileIndex;  // H is raw group zero.
  const int rankOffset = (rawGroup % 2 == 0) ? (8 - rank) : (rank - 1);
  const int rawSquare = rawGroup * 8 + rankOffset;
  const int localRow = row % 2;
  const int localColumn = column % 2;
  const int localPosition = localRow * 2 + localColumn;  // TL, TR, BL, BR.
  static const uint8_t offsetsByFile[8][4] = {
    {1, 2, 0, 3},  // A
    {2, 1, 3, 0},  // B
    {0, 3, 1, 2},  // C
    {2, 1, 3, 0},  // D
    {1, 2, 0, 3},  // E
    {2, 1, 3, 0},  // F
    {1, 2, 0, 3},  // G
    {3, 0, 2, 1}   // H
  };
  return rawSquare * 4 + offsetsByFile[fileIndex][localPosition];
}

const uint8_t* promotionGlyph(char piece) {
  static const uint8_t queen[9] = {0x3E, 0x41, 0x41, 0x41, 0x41, 0x49, 0x45, 0x3E, 0x03};
  static const uint8_t rook[9] = {0x7E, 0x41, 0x41, 0x41, 0x7E, 0x48, 0x44, 0x42, 0x41};
  static const uint8_t bishop[9] = {0x7E, 0x41, 0x41, 0x41, 0x7E, 0x41, 0x41, 0x41, 0x7E};
  static const uint8_t knight[9] = {0x41, 0x61, 0x61, 0x51, 0x49, 0x45, 0x43, 0x43, 0x41};
  static const uint8_t pawn[9] = {0x7E, 0x41, 0x41, 0x41, 0x7E, 0x40, 0x40, 0x40, 0x40};
  switch (piece) {
    case 'q': return queen;
    case 'r': return rook;
    case 'b': return bishop;
    case 'n': return knight;
    case 'p': return pawn;
    default: return nullptr;
  }
}

void drawPromotionGlyph(char piece) {
  const uint8_t* glyph = promotionGlyph(piece);
  strip.clear();
  if (!glyph) {
    strip.show();
    return;
  }
  constexpr int top = 3;
  constexpr int left = 4;
  const uint32_t color = strip.Color(180, 80, 255);
  for (int row = 0; row < 9; row++) {
    for (int column = 0; column < 7; column++) {
      if ((glyph[row] & (1U << (6 - column))) == 0) continue;
      const int pixel = promotionMatrixPixelToStrip(top + row, left + column);
      if (pixel >= 0) strip.setPixelColor(pixel, color);
    }
  }
  if (promotionLedDisplay.targetIndex >= 0 && promotionLedDisplay.targetIndex < 64) {
    setSquareColor(promotionLedDisplay.targetIndex, 255, 180, 40);
  }
  strip.show();
}

void applyPromotionLedCommand(JsonObject command) {
  // Promotion instructions must take priority over a running game-over animation.
  activeLedAnimation = LED_ANIM_NONE;
  ledAnimationKingA = -1;
  ledAnimationKingB = -1;

  const char* state = command["state"] | "clear";
  const char* transactionId = command["transactionId"] | "";
  const char* pieceText = command["piece"] | "";
  const char piece = pieceText[0] ? static_cast<char>(tolower(pieceText[0])) : 0;

  if (strcmp(state, "clear") == 0) {
    promotionLedDisplay = PromotionLedDisplay{};
    strip.clear();
    strip.show();
    markSnapshotDirty();
    return;
  }

  promotionLedDisplay.active = true;
  promotionLedDisplay.transactionId = transactionId;
  promotionLedDisplay.state = state;
  promotionLedDisplay.targetIndex = command["targetIndex"] | -1;
  promotionLedDisplay.intervalMs = command["intervalMs"] | 2500;
  promotionLedDisplay.lastChangeMs = millis();
  promotionLedDisplay.choiceIndex = 0;
  promotionLedDisplay.lockedPiece = piece;
  if (strcmp(state, "cycle") == 0) {
    promotionLedDisplay.displayedPiece = 'q';
  } else if (strcmp(state, "pawn") == 0) {
    promotionLedDisplay.displayedPiece = 'p';
  } else if (piece) {
    promotionLedDisplay.displayedPiece = piece;
  } else {
    promotionLedDisplay.displayedPiece = 'p';
  }
  drawPromotionGlyph(promotionLedDisplay.displayedPiece);
  markSnapshotDirty();
}

void servicePromotionLedDisplay(uint32_t now) {
  if (!promotionLedDisplay.active || promotionLedDisplay.state != "cycle") return;
  if (now - promotionLedDisplay.lastChangeMs < promotionLedDisplay.intervalMs) return;
  static const char choices[4] = {'q', 'r', 'b', 'n'};
  promotionLedDisplay.choiceIndex = (promotionLedDisplay.choiceIndex + 1) % 4;
  promotionLedDisplay.displayedPiece = choices[promotionLedDisplay.choiceIndex];
  promotionLedDisplay.lastChangeMs = now;
  drawPromotionGlyph(promotionLedDisplay.displayedPiece);
  markSnapshotDirty();
}

void applyLedCommand(JsonObject command) {
  stopExhibitionRendering();
  const char* mode = command["mode"] | "";
  if (strcmp(mode, "capture-start") == 0) { applyCaptureStart(command); return; }
  if (strcmp(mode, "promotion-display") == 0) {
    applyPromotionLedCommand(command);
    return;
  }
  if (promotionLedDisplay.active) {
    promotionLedDisplay = PromotionLedDisplay{};
    markSnapshotDirty();
  }
  activeLedAnimation = LED_ANIM_NONE;
  ledAnimationKingA = -1;
  ledAnimationKingB = -1;

  if (strcmp(mode, "human-move-confirm") == 0) {
    applyHumanMoveConfirm(command);
    return;
  }

  if (strcmp(mode, "led-runway") == 0) {
    JsonArray segments = command["segments"].as<JsonArray>();
    if (!segments.isNull()) {
      for (JsonObject segment : segments) {
        runLedRunway(segment);
      }
    } else {
      runLedRunway(command);
    }
    return;
  }

  if (strcmp(mode, "overlay") != 0) {
    strip.clear();
  }

  JsonArray squares = command["squares"].as<JsonArray>();
  int squareOrdinal = 0;
  for (JsonObject square : squares) {
    const int index = square["index"] | -1;
    if (index < 0 || index >= 64) continue;

    if (squareOrdinal == 0) ledAnimationKingA = index;
    if (squareOrdinal == 1) ledAnimationKingB = index;
    squareOrdinal++;

    JsonObject color = square["color"];
    const uint8_t r = color["r"] | 0;
    const uint8_t g = color["g"] | 0;
    const uint8_t b = color["b"] | 0;
    setSquareColor(index, r, g, b);
  }

  if (strcmp(mode, "celebrate-checkmate") == 0) {
    activeLedAnimation = LED_ANIM_CHECKMATE;
    lastLedAnimationMs = 0;
    updateLedAnimation();
    return;
  }

  if (strcmp(mode, "celebrate-stalemate") == 0) {
    activeLedAnimation = LED_ANIM_STALEMATE;
    lastLedAnimationMs = 0;
    updateLedAnimation();
    return;
  }

  if (strcmp(mode, "celebrate-draw") == 0) {
    activeLedAnimation = LED_ANIM_DRAW;
    lastLedAnimationMs = 0;
    updateLedAnimation();
    return;
  }

  strip.show();
}

void setSquareColor(int squareNumber, uint8_t r, uint8_t g, uint8_t b) {
  const int startingLED = squareNumber * 4;
  for (int i = 0; i < 4; i++) {
    strip.setPixelColor(startingLED + i, strip.Color(r, g, b));
  }
}

void clearBoardLeds() {
  strip.clear();
  strip.show();
}

void setNeighborSquaresColor(int centerIndex, uint8_t r, uint8_t g, uint8_t b) {
  if (centerIndex < 0 || centerIndex >= 64) return;

  const long centerY = squareCoordinates[centerIndex][0];
  const long centerX = squareCoordinates[centerIndex][1];
  for (int index = 0; index < 64; index++) {
    if (index == centerIndex) continue;

    const long dy = labs(squareCoordinates[index][0] - centerY);
    const long dx = labs(squareCoordinates[index][1] - centerX);
    if (dx <= HALO_NEIGHBOR_MAX_DELTA && dy <= HALO_NEIGHBOR_MAX_DELTA) {
      setSquareColor(index, r, g, b);
    }
  }
}

void applyHumanMoveConfirm(JsonObject command) {
  const int targetIndex = command["targetIndex"] | -1;
  const int flashes = command["flashes"] | 2;
  if (targetIndex < 0 || targetIndex >= 64) {
    clearBoardLeds();
    return;
  }

  for (int i = 0; i < flashes; i++) {
    strip.clear();
    setSquareColor(targetIndex, 80, 255, 120);
    strip.show();
    delay(110);
    strip.clear();
    strip.show();
    delay(90);
  }
}

void applyCaptureStart(JsonObject step) {
  strip.clear();

  JsonObject attacker = step["attacker"];
  const int attackerIndex = attacker["index"] | -1;
  if (attackerIndex >= 0 && attackerIndex < 64) {
    setSquareColor(attackerIndex, 80, 130, 255);
  }

  JsonObject captured = step["captured"];
  const int capturedIndex = captured["index"] | -1;
  if (capturedIndex >= 0 && capturedIndex < 64) {
    setSquareColor(capturedIndex, 255, 40, 40);
  }

  strip.show();
  const int holdMs = step["holdMs"] | 1000;
  delay(holdMs);
}

void runLedRunway(JsonObject step) {
  JsonArray squares = step["squares"].as<JsonArray>();
  if (squares.isNull() || squares.size() == 0) return;

  JsonObject color = step["color"];
  const uint8_t r = color["r"] | 80;
  const uint8_t g = color["g"] | 220;
  const uint8_t b = color["b"] | 120;
  const int stepDelayMs = step["stepDelayMs"] | 250;
  const int holdMs = step["holdMs"] | 500;
  const bool clearWhenDone = step["clearWhenDone"] | false;

  strip.clear();
  strip.show();

  for (JsonObject square : squares) {
    const int index = square["index"] | -1;
    if (index < 0 || index >= 64) continue;
    setSquareColor(index, r, g, b);
    strip.show();
    delay(stepDelayMs);
  }

  delay(holdMs);
  if (clearWhenDone) {
    clearBoardLeds();
  }
}

uint32_t colorWheel(byte position) {
  position = 255 - position;
  if (position < 85) {
    return strip.Color(255 - position * 3, 0, position * 3);
  }
  if (position < 170) {
    position -= 85;
    return strip.Color(0, position * 3, 255 - position * 3);
  }
  position -= 170;
  return strip.Color(position * 3, 255 - position * 3, 0);
}

void updateLedAnimation() {
  if (activeLedAnimation == LED_ANIM_NONE) return;

  const uint32_t now = millis();
  if (now - lastLedAnimationMs < 55) return;
  lastLedAnimationMs = now;

  const uint8_t frame = (now / 55) % 255;
  for (int square = 0; square < 64; square++) {
    uint32_t color;
    if (activeLedAnimation == LED_ANIM_CHECKMATE) {
      color = colorWheel((frame * 4 + square * 7) & 255);
    } else if (activeLedAnimation == LED_ANIM_STALEMATE) {
      const bool alternate = ((square + frame / 8) % 2) == 0;
      color = alternate ? strip.Color(150, 80, 255) : strip.Color(255, 180, 40);
    } else {
      const uint8_t pulse = 60 + ((frame % 80) * 2);
      color = strip.Color(pulse, 40, 180);
    }

    const int startingLED = square * 4;
    for (int pixel = 0; pixel < 4; pixel++) {
      strip.setPixelColor(startingLED + pixel, color);
    }
  }

  const bool flashOn = ((now / 220) % 2) == 0;
  if (activeLedAnimation == LED_ANIM_CHECKMATE) {
    if (ledAnimationKingA >= 0) {
      setNeighborSquaresColor(ledAnimationKingA, 120, 0, 0);
    }
    if (ledAnimationKingB >= 0) {
      setNeighborSquaresColor(ledAnimationKingB, 0, 80, 140);
    }
    if (ledAnimationKingA >= 0) {
      setSquareColor(ledAnimationKingA, flashOn ? 255 : 0, 0, 0);
    }
    if (ledAnimationKingB >= 0) {
      setSquareColor(ledAnimationKingB, 0, flashOn ? 255 : 0, flashOn ? 120 : 0);
    }
  } else {
    if (ledAnimationKingA >= 0) {
      setNeighborSquaresColor(ledAnimationKingA, 130, 80, 0);
    }
    if (ledAnimationKingB >= 0) {
      setNeighborSquaresColor(ledAnimationKingB, 95, 40, 145);
    }
    if (ledAnimationKingA >= 0) {
      setSquareColor(ledAnimationKingA, flashOn ? 255 : 0, flashOn ? 210 : 0, 0);
    }
    if (ledAnimationKingB >= 0) {
      setSquareColor(ledAnimationKingB, flashOn ? 170 : 0, flashOn ? 60 : 0, flashOn ? 255 : 0);
    }
  }

  strip.show();
}
