The-Jaaa/esp32-autonomous-chessboard/offline_core/src/offline_promotion_motion_arduino.cpp

#include "EmbeddedConfig.h"

#if ENABLE_OFFLINE_PROMOTION_MOTION_DIAGNOSTICS || \
    ENABLE_OFFLINE_UNIFIED_TURN_DIAGNOSTICS || \
    ENABLE_OFFLINE_PRODUCTION_INTERACTION_DIAGNOSTICS || \
    ENABLE_OFFLINE_CONTINUOUS_GAMEPLAY_DIAGNOSTICS
#include "../offline_promotion_motion.cpp"
#endif
