The-Jaaa/esp32-autonomous-chessboard/offline_core/src/offline_unified_motion_arduino.cpp

#include "EmbeddedConfig.h"

#if ENABLE_OFFLINE_UNIFIED_TURN_DIAGNOSTICS || \
    ENABLE_OFFLINE_PRODUCTION_INTERACTION_DIAGNOSTICS || \
    ENABLE_OFFLINE_CONTINUOUS_GAMEPLAY_DIAGNOSTICS
#include "../offline_unified_motion.cpp"
#endif
