The-Jaaa/esp32-autonomous-chessboard/offline_core/src/offline_motion_arduino.cpp

#include "EmbeddedConfig.h"

#if ENABLE_OFFLINE_EMBEDDED_DIAGNOSTICS || ENABLE_OFFLINE_RUNTIME_DIAGNOSTICS || \
    ENABLE_OFFLINE_PHASE_EXECUTION_DIAGNOSTICS || \
    ENABLE_OFFLINE_QUIET_MOTION_DIAGNOSTICS || \
    ENABLE_OFFLINE_CAPTURE_MOTION_DIAGNOSTICS || \
    ENABLE_OFFLINE_LANE_MOTION_DIAGNOSTICS
#include "../offline_motion.cpp"
#endif
