The-Jaaa/esp32-autonomous-chessboard/offline_core/offline_phase_execution.cpp

#include "offline_phase_execution.h"

#include <utility>

namespace offline {
namespace {

bool executionFinished(OfflineTurnPhase phase) {
  return phase == OfflineTurnPhase::HumanTurn ||
         phase == OfflineTurnPhase::GameOver;
}

}  // namespace

OfflinePhaseExecutionAdapter::OfflinePhaseExecutionAdapter(
    OfflineReadOnlyRuntime& runtime)
    : runtime_(runtime) {}

void OfflinePhaseExecutionAdapter::setRuntimePhase(OfflineRuntimePhase phase) {
  runtime_.phase_ = phase;
}

OfflinePhaseExecutionUpdate OfflinePhaseExecutionAdapter::updateFor(
    OfflinePhaseExecutionEvent event,
    std::string message,
    std::optional<OfflineTurnResult> result) const {
  OfflinePhaseExecutionUpdate update;
  update.state = state_;
  update.event = event;
  update.request = request_;
  update.coordinatorResult = std::move(result);
  if (update.coordinatorResult) {
    update.differenceFromBefore = update.coordinatorResult->differenceFromBefore;
    update.differenceFromExpected = update.coordinatorResult->differenceFromExpected;
  }
  update.message = std::move(message);
  return update;
}

OfflinePhaseExecutionUpdate OfflinePhaseExecutionAdapter::issueCurrentPhase(
    OfflinePhaseExecutionState state,
    OfflinePhaseExecutionEvent event,
    std::string message,
    std::uint32_t attempt) {
  const auto transaction = runtime_.coordinator_.pendingMotionTransaction();
  if (!transaction || transaction->currentPhase >= transaction->motion.phases.size()) {
    state_ = OfflinePhaseExecutionState::Error;
    request_.reset();
    setRuntimePhase(OfflineRuntimePhase::Error);
    return updateFor(
        OfflinePhaseExecutionEvent::Error,
        "The coordinator has no current motion phase for the adapter.");
  }

  OfflinePhaseExecutionRequest request;
  request.token.transactionId = transaction->transactionId;
  request.token.phaseIndex = transaction->currentPhase;
  std::uint32_t lastAttempt = 0;
  for (const OfflinePhaseExecutionToken& token : issuedTokens_) {
    if (token.transactionId == transaction->transactionId &&
        token.phaseIndex == transaction->currentPhase &&
        token.attempt > lastAttempt) {
      lastAttempt = token.attempt;
    }
  }
  if (attempt == 0) {
    attempt = lastAttempt + 1;
  } else if (attempt <= lastAttempt) {
    attempt = lastAttempt + 1;
  }
  request.token.attempt = attempt;
  request.move = transaction->motion.move;
  request.phase = transaction->motion.phases[transaction->currentPhase];
  request.graveyardSlotKey = transaction->graveyardSlotKey;
  request.graveyardState = transaction->graveyardState;
  request_ = std::move(request);
  issuedTokens_.push_back(request_->token);
  state_ = state;
  setRuntimePhase(OfflineRuntimePhase::OpponentExecuting);
  return updateFor(event, std::move(message));
}
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
