The-Jaaa/esp32-autonomous-chessboard/(commit log)

2026-07-14 feat: add host-only board route planner
2026-07-14 feat: add ESP32 offline resource diagnostics
2026-07-16 feat: add guarded offline staged capture diagnostic
2026-07-17 test(firmware): add LED core comparison diagnostic
2026-07-17 Add LED index calibration diagnostic
2026-07-20 Add Gemini mentor board tools
2026-07-20 Ground mentor analysis with Stockfish
2026-07-20 Give Gemini Live mentor board tools
2026-07-21 Add targeted ESP32 mentor speaker output
2026-07-22 Add physical mentor observer and harden board audio
2026-07-22 feat(mentor): coordinate physical opening drills
2026-07-22 fix(mentor): recover stalled physical opening guidance
2026-08-07 Fix mentor-led physical reply execution
2026-08-07 Ground physical coaching and recover Live voice
2026-08-09 Fix offline interaction feedback and homing
2026-08-09 Add offline LED orientation and palette parity
2026-08-09 Fix offline LED parity hardware dispatch
2026-08-11 Add supervised Spotify Wi-Fi relay core
2026-08-11 Integrate Spotify relay with mentor audio
2026-08-11 Add ESP32 Spotify audio coordinator
2026-08-23 Preserve PCM alignment across Spotify track gaps
2026-11-09 Finalize Exhibition, Spectrum, autonomous recovery and Stockfish 19 Ultra
    Add idle Exhibition controls, eight-band audio Spectrum, reversible autonomous playback and guarded placement recovery. Migrate game and Mentor engines to pinned native Stockfish 19 and enable three-second Ultra for virtual and ordinary physical games. Include regression coverage, firmware gates and current setup documentation.
